akita11/EyeTracker/doc/README.md

* このファイルについて

EyeTrackのFPGAデザインに関する説明資料になります。
基板資料、FPGAデバイス資料についてはdoc以下のファイルを参照ください。

* FPGAデザイン

HUMANDATA社製　Xilinx社Kintex-7 FPGA搭載(Kintex-7 XC7K160T-1FBGA484) XCM-112基板向けデザインです、
関連資料については下記URLより参照ください。

http://www.hdl.co.jp/EDX-009/index.html
