akita11/EyeTracker/doc/EyeTracker -Register Specification-.pdf

Address | Mode | Data
UART_SW | R/W | 7 | 6 | 5 | 4 | 3 | 2 | 1 | 0
0x0000 | | - | - | - | - | - | - | - | SW
VGAOUT_MODE | R/W | 7 | 6 | 5 | 4 | 3 | 2 | 1 | 0
0x0001 | | - | - | - | - | - | - | - | VGAMD
THRESHOLD | R/W | 7 | 6 | 5 | 4 | 3 | 2 | 1 | 0
0x0002 | | THRESHOLD[7:0]
CURSOR_MODE | R/W | 7 | 6 | 5 | 4 | 3 | 2 | 1 | 0
0x0003 | | - | - | - | - | - | - | OUT_SEL | CURMD
SUM_S[ 7: 0] | R/O | 7 | 6 | 5 | 4 | 3 | 2 | 1 | 0
0x0004 | | SUM_S[ 7: 0]
SUM_S[15: 8] | R/O | 7 | 6 | 5 | 4 | 3 | 2 | 1 | 0
0x0005 | | SUM_S[15: 8]
SUM_S[15: 8] | R/O | 7 | 6 | 5 | 4 | 3 | 2 | 1 | 0
0x0006 | | - | - | - | - | SUM_S[23:16]
- | R/O | 7 | 6 | 5 | 4 | 3 | 2 | 1 | 0
0x0007 | | - | - | - | - | - | - | - | -
SUM_SX[ 7: 0] | R/O | 7 | 6 | 5 | 4 | 3 | 2 | 1 | 0
0x0008 | | SUM_SX[ 7: 0]

∑SX値

Reserved

∑S値

∑S値

∑S値

OUT_SEL : 0 = S/SX/SYを出力, 1 = S/QSX/QSYを出力(整数部12bit/小数部16bit)

SW : 0 = UARTを重心計算結果出力として使用 1 = UARTをHost IFとして使用

VGAMD : 0 = 2値化画像を出力 1 = Rawデータを出力

THRESHOLD[7:0] : 2値化のしきい値

CURMD : 0 = 重心カーソル表示Off, 1 = 重心カーソル表示On

SUM_SX[15: 8] | R/O | 7 | 6 | 5 | 4 | 3 | 2 | 1 | 0
0x0009 | | SUM_SX[15: 8]
SUM_SX[23:16] | R/O | 7 | 6 | 5 | 4 | 3 | 2 | 1 | 0
0x000A | | SUM_SX[23:16]
SUM_SX[27:24] | R/O | 7 | 6 | 5 | 4 | 3 | 2 | 1 | 0
0x000B | | - | - | - | - | SUM_SX[27:24]
SUM_SY[ 7: 0] | R/O | 7 | 6 | 5 | 4 | 3 | 2 | 1 | 0
0x000C | | SUM_SY[ 7: 0]
SUM_SY[15: 8] | R/O | 7 | 6 | 5 | 4 | 3 | 2 | 1 | 0
0x000D | | SUM_SY[15: 8]
SUM_SY[23:16] | R/O | 7 | 6 | 5 | 4 | 3 | 2 | 1 | 0
0x000E | | SUM_SY[23:16]
SUM_SY[27:24] | R/O | 7 | 6 | 5 | 4 | 3 | 2 | 1 | 0
0x000F | | - | - | - | - | SUM_SY[27:24]
Q_SX[ 7: 0] | R/O | 7 | 6 | 5 | 4 | 3 | 2 | 1 | 0
0x0010 | | Q_SX[ 7: 0]
Q_SX[15: 8] | R/O | 7 | 6 | 5 | 4 | 3 | 2 | 1 | 0
0x0011 | | Q_SX[15: 8]

∑SY値

Q_SX.F_SX = ∑SX/∑S

Q_SX.F_SX = ∑SX/∑S

∑SY値

∑SY値

∑SX値

∑SY値

∑SX値

∑SX値

Q_SX[23:16] | R/O | 7 | 6 | 5 | 4 | 3 | 2 | 1 | 0
0x0012 | | Q_SX[23:16]
Q_SX[27:24] | R/O | 7 | 6 | 5 | 4 | 3 | 2 | 1 | 0
0x0013 | | - | - | - | - | Q_SX[27:24]
Q_SY[ 7: 0] | R/O | 7 | 6 | 5 | 4 | 3 | 2 | 1 | 0
0x0014 | | Q_SY[ 7: 0]
Q_SY[15: 8] | R/O | 7 | 6 | 5 | 4 | 3 | 2 | 1 | 0
0x0015 | | Q_SY[15: 8]
Q_SY[23:16] | R/O | 7 | 6 | 5 | 4 | 3 | 2 | 1 | 0
0x0016 | | Q_SY[23:16]
Q_SY[27:24] | R/O | 7 | 6 | 5 | 4 | 3 | 2 | 1 | 0
0x0017 | | - | - | - | - | Q_SY[27:24]
F_SX[ 7: 0] | R/O | 7 | 6 | 5 | 4 | 3 | 2 | 1 | 0
0x0018 | | F_SX[ 7: 0]
F_SX[15: 8] | R/O | 7 | 6 | 5 | 4 | 3 | 2 | 1 | 0
0x0019 | | F_SX[15: 8]
F_SX[ 19:16] | R/O | 7 | 6 | 5 | 4 | 3 | 2 | 1 | 0
0x001A | | - | - | - | - | F_SX[19:16]

Q_SX = ∑SX/∑S

Q_SX.F_SX = ∑SX/∑S

Q_SX.F_SX = ∑SX/∑S

Q_SY.F_SY = ∑SY/∑S

Q_SY.F_SY = ∑SY/∑S

Q_SX.F_SX = ∑SX/∑S

Q_SY.F_SY = ∑SY/∑S

Q_SY.F_SY = ∑SY/∑S

Q_SX.F_SX = ∑SX/∑S

- | R/O | 7 | 6 | 5 | 4 | 3 | 2 | 1 | 0
0x001B | | - | - | - | - | - | - | - | -
F_SY[ 7: 0] | R/O | 7 | 6 | 5 | 4 | 3 | 2 | 1 | 0
0x001C | | F_SY[ 7: 0]
F_SY[15: 8] | R/O | 7 | 6 | 5 | 4 | 3 | 2 | 1 | 0
0x001D | | F_SY[15: 8]
F_SY[ 19:16] | R/O | 7 | 6 | 5 | 4 | 3 | 2 | 1 | 0
0x001E | | - | - | - | - | F_SY[19:16]
- | R/O | 7 | 6 | 5 | 4 | 3 | 2 | 1 | 0
0x001F | | - | - | - | - | - | - | - | -

Q_SY.F_SY = ∑SY/∑S

Reserved

Q_SY.F_SY = ∑SY/∑S

Q_SY.F_SY = ∑SY/∑S

Reserved
