akita11/EyeTracker/(threads)

Thread 1 (2017-04-01):

FRAME切り替え処理不具合

watari3, 2017-04-01:
Dual Port SRAMのm_MEMA0/m_MEMB0のアクセス制御に問題あり。
Multi Frame回路を実装して対応する必要あり。

A port側はカメラのフレームでアクセス切り替えするよう修正が必要か？？？
B port側は現行通りで問題なし。

watari3, 2017-05-23:
Close条件
・SIMでW/R処理が適切になされていることを確認すること(確認済み)
・実機でVGA出力(アナログRGB)に入力信号が出力されていること(下位３ビットは0)を確認すること(未確認)

watari3, 2017-06-05:
issue #20, issue #21にて個別に対応しているためissue #1は取り敢えずclose

Closed 2017-06-05.

Thread 2 (2017-04-01):

重心計算処理

watari3, 2017-04-01:
重心計算処理は参考資料通りに実装する。

計算途中のデータはF/Fで保持することとする。

watari3, 2017-04-15:
S/SX/SYの合計算出回路実装完了
除算は後ほど実装

akita11, 2017-05-29:
1つ確認をさせてください。実機での重心計算回路の検証は、どのように行われていますか？
カメラで適当な画像を撮り、その画像を動かすと、演算結果のS, SX, SYの値も、変化する（その値が正しいかは別として）、という動作は実機で確認していますか？

watari3, 2017-05-29:
かなり前のコードになりますが、vgaout_mode=0, threshold=0x01としてsum_s, sum_sx, sum_syが変わることをILAにて確認しております。
なお単体演算回路はシミュレーションで確認しております。

計算処理部分が少し特殊な記述で対応しているため合成時に変になる可能性は否定できません。
後ほど合成ログを確認してみます。

akita11, 2017-05-30:
CLctrl.vをみていて気づいたのですすが、二値化の処理、以下のようになっていますよね。
`oMEMIN_0[i  ] <= (iDATA_L>iTHRESHOLD) ? 1'b1: oMEMIN_0[i  ];`
これだと、輝度がiTHRESHOLDより大きい（明るい）画素が1になって、その画素にたいして重心計算されること、になりますよね。（この理解は正しいですか？）

本来行いたいのは、THRESHOLDよりも暗い画素に対する重心計算、なのですが、そのためには、この不等号は逆、という理解でよろしいですか？（この理解が正しいのであれば私のほうで修正しておきます）

watari3, 2017-05-30:
オリジナルのソースと思われるものが
oMEMIN_0[i ] <= (iDATA_L>iTHRESHOLD) ? 1'b1: oMEMIN_0[i ];
という記述でしたので、そのまま実装しています。

これが仕様とは正反対ということであれば修正が必要ですね。
こちらでも修正しておきます。

pushは私が行ったほうが良いでしょうか？

akita11, 2017-05-30:
私が今日の夕方にこの修正を行ってcommitしていますので、まずはそれをpullしてください。

またvgaout_mode=0(digitize)のときに、この二値化に基づいた画像がVGA側で表示されない原因は、なにか思い当たる節はありますか？

watari3, 2017-05-30:
issue #3 UART対応　の方に思い当たることを記載しました。
ご参照ください。

watari3, 2017-06-18:
除算含む重心計算処理を行い、VGA出力に重心位置を赤色で出力するよう実装。

watari3, 2017-06-26:
動作確認が取れた (issue #25 )ので本件close

Closed 2017-06-26.

Thread 3 (2017-04-01):

UART対応

watari3, 2017-04-01:
UART対応として以下の機能を実装する。
機能排他とするため、外部JPなどで切り替えを行う。

・内部レジスタアクセス制御(UART Tx, Rx使用)
・重心結果のみ出力

watari3, 2017-04-05:
UART回路としてUART_RX_CORE.v UART_TX_CORE.vを追加

上位層の回路作成必要

watari3, 2017-05-20:
上記「重心結果のみ出力」を実装済み。

akita11, 2017-05-21:
直接は関係ありませんが、TXとRXのピン番号指定が逆だったので、修正しておきました。

watari3, 2017-05-25:
改行コードを出力するように修正 (ステートマシーンの記述ミスを修正)

akita11, 2017-05-29:
UARTの出力で、ちょっと理解に苦しむところがあります。
カメラで撮っている画像や閾値の設定は適当ですので、出てくるS、SX、SYの値そのものは適当な値ということで、その妥当性は無視しています。

ロジアナ波形で、このような部分があります。
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

(1)この付近では、uart_dataに0x30があることから、これが送られているはずで、7bit/no parity/1stop
 bitだと、出力ビット列は、0 0000110 1、となるはずです。（最初の0がstart、最後の1がstop、その間の7bitが0x30）つまりこの青と黄のマーカの間隔は1bit分の時間ということになります。この青と黄のマーカの間隔は、この横軸では4519-4308=211ですが、オシロで計測すると9.2usとなっています。これは約115200bpsに相当しますが、ビットレートはその2倍の230400bps、のはずですよね。（つまりビットレートが115200bpsなのではないか？という推測）

(2)この付近で送っているデータ(uart_data)がこちら。
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
これをみると、19個の0x30のあと、0x00が送られています。
この0x00あたりを拡大したのがこちら。
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

0x30のあと、一瞬0xffになったあと、0x00になっています。
仕様では、区切りは0x0d、と記憶していますが、これはバグでしょうか。

akita11, 2017-05-29:
↑こちら、別便のメールで連絡をいただいていた、更新を反映させる前のものでした。失礼しました。これから反映させて試してみます。

akita11, 2017-05-29:
↑↑昨日の朝いただいた最新のリポジトリ(2017/5/28 20:14)をpullして書き込んでみました。
UARTから出てくるのは、230400bpsになりましたが、やはり19個の0x30＋0x00、の繰り返しです。
↑↑の(2)と(3)、確認＆情報ください。

watari3, 2017-05-29:
症状の確認をしたいと思います。
お手数ですが下記をご対応いただけないでしょうか。

1) JPのピン配置及び設定は適切か、
2) 改行コードが出力されていない、とは0x0Dが出力されていないとのことか。0x0A(LF)を出力する仕様ではなく0x0D(CR)を出力する仕様に変更すべきか。それとも0x0D, 0x0Aと出力すべきか。
3) TOP.vの後ろの記述を以下に変更しsum_sを観測しsum_sが0以外となっているか。
        .probe18(sum_s[7:0]/*VGA_R*/),
        .probe19(sum_s[8]/*clk_uart_x8*/),
        .probe20(sum_s[9]/*start_trig*/),
        .probe21(sum_s[10]/*uart_de*/),
        .probe22(sum_s[18:11]/*uart_data*/),
        .probe23(sum_s[19]/*tx_busy*/) /*,*/
4) vgaout_modeを0にした場合sum_sなどUARTの出力値が現在の結果から変化するか。

現在JP設定を疑っています。
またUARTの方は仕様の確認ということで質問しています。

ご対応いただければ幸いです。

watari3, 2017-05-29:
【仕様】
・sum_s(5キャラクタ)sum_sx(7キャラクタ)sum_sy(7キャラクタ)改行コード(1キャラクタ)
【バグ】
・改行コードが0x0と出力される。
・改行コードは0x0D
【対応方法】
・UART_IF.v/310行目 LSB側に詰めて設定しているものをMSB側に詰める様修正する必要あり
→next_hold_data  <= {8'h0A, 48'h0 };の様に修正

帰宅後にコードをコミットします。

akita11, 2017-05-30:
UART出力データの仕様→理解しました（確認ですが16進表記の5/7キャラクタ、ですよね？）。出てくるデータは上のほうに書いたのですが、改行コードと思われるところに0x00が出てきています。改行コードは、0x0aでも0x0dでも、その2つ、でもかまいません（PC側であわせます）。現行の仕様が0x0aのみ、なので、対応方法のところを読むと、0x0aの1バイトのまま、とするのがよさそうですね。↑の対応方法、というのを試してみたいと思います。

1.JPピン→上記の通り、適当に設定しています（本来はVGAOUT=0として二値化の状況を確認しながらJPを設定すべきですが、現在行っている動作チェックは、(a)生画像出力（これはOK）、(b)UARTから出てくる値のフォーマットの確認（19バイトの16進数文字＋改行コード、が出ているか。これは↑のとおり改行コードのところに0x00が出てきている）、です。S/SX/SYの値が、正しいかどうか、は、いまは気にしていません（正しい値を得るためにはJPを適切に設定する必要があるが、いまはそれ以前の段階）。
3.4.は、これからやってみます。

akita11, 2017-05-30:
↑の件、UART_IF.vに「対応方法」の修正を行い、改行コード0x0aが20バイトごとに出てくることは確認できました。
S/SX/SYの値はすべて'0'(0x30)となっていますが、これはJPの閾値の設定が不適切なのが原因と思われるので、引き続き調整してみます。

akita11, 2017-05-30:
JPの設定の件、原因がわかった気がします。状況確認とあわせて、読んでください。
まず確認ですが、vgaout_mode=0(digitized)のときは、JPで設定した閾値より明るい画素が"1"、それ以外の画素が"0"となって、VGA出力では、それに応じた二値画像が表示される、という動作という理解でよろしいですね？

で、ボードの回路図をみていただくとわかるのですが、JP[7:0]は、ショートピンをおくと3Vにつながるようになっています。つまりショートピンがない状態では0になるようにプルダウンされるべき信号です。
TOP_implement.tclでは、
`set_property PULLUP TRUE [get_ports [list JP[*]]]`
と書いてあるので、これを
`set_property PULLDOWN TRUE [get_ports [list JP[*]]]`
とすれば、プルダウンになって、ショートピンなし=0、あり=1、となるはずですよね。

で、このように書き換えてimplementをしてみたのですが、ショートピンがないピンが"1"のまま、で、プルダウンが効いていないっぽいです。
implementのレポート（以下）でピン配置結果をみると、PULLUPもPULLDOWMの指定されているっぽいところがないのですが、本来は、正しくPULLUP/DOWNが設定されると、このレポートのどこに出てくるか、わかりますか？（＝ここどこにもPULLUP/DOWNが出てこないのでTOP_implement.tclでのPULLUP/DOWNの指定の仕方が違うのではないか？と疑っている）
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

akita11, 2017-05-30:
↑の件、ImplementationのI/O planningでみると、JP[7:0]がPULLUP指定のままで、ここからPULLDOWNに指定できそうなので、やってみます。このTOP_implement.tclを明示的に読み込みなおす、とやらないと、反映されないんですかね。

akita11, 2017-05-30:
↑のPULLDOWN指定はうまくいきました（書き込んで、JPが、ショートピンなし＝"0"、あり＝"1"にできるようになった）。ただvgaout_mode=0(digitize)のときのVGAモニタに映る映像が、前面グレーのまま、です（中央やや下の左寄りに黒い四角が1個だけ現れる：以下の画像）。これはJPの設定をいろいろ変えてみましたが、映る映像は変わりません。
https://www.dropbox.com/s/yb3d01o3ajafzfo/2017-05-30%2012.58.50.jpg?dl=0

カメラに映している映像は、黒いところも明るいところもそれなりにある映像です（以下）。なおこの映像が、上のほうの細長い領域しか映っていないのは、仕様（カメラでそう設定している）で正しい現象です。
https://www.dropbox.com/s/p3v4wqy6yj755lb/2017-05-30%2012.58.05.jpg?dl=0

akita11, 2017-05-30:
（自分への備忘録）VGAout.vを読んで、vgaout_mode=0(digitize)のときのVGA出力が、画素ごとにフラグ=1→0xc0、フラグ=0→0x00、となるのは理解しました。ここですね。
```
    assign  mem_dat = (iVGAout_mode==1'b0) ? {sel_memout_0, sel_memout_0, 6'b000000}:
                                             {sel_memout_1, sel_memout_2, sel_memout_3, sel_memout_4, sel_memout_5, 3'b000};

```

akita11, 2017-05-30:
ILAの.proveで、JPの値を見たりしながら、いろいろいじってみました。わかったこと、おこった現象、をいくつか。
・ロジアナでJP（から設定されているthreshold）の値を読んだところ、ジャンパピンで設定したとおりの値になっていることは確認しました。つまり閾値の設定は正常。
・「重心計算処理」issueに書いたように、本来は重心の計算は黒画素に対して行うので、フラグを立てる条件式の不等号を逆（画素値＜threshold）にしました。vgaout_mode=0(digitize)時に表示される映像は、変化ありません。ただ、ときどき（再現性なし）、ここで、縦縞が出ることとがあります。カメラを動かすと、縦縞が変わったり消えたりします。（出ないときもある）。縦縞は、本当に縦縞で、X方向には何本かのグレー／黒の模様があり、Y方向にはその模様が一直線に続く、つまり画像メモリへのアクセスで、Y方向アドレスが一定になってしまっている、っぽい現象です。
・このときにUARTから出てくる値は、0ではない値のときがありました。ただこれも、画像を変えても変化しなかったり変化したり、と再現性がありません。

上記の変更をcommitしておきました。これらの現象の原因をみていただけますか。必要でしたら実機をお渡しします。

watari3, 2017-05-30:
Block RAMのWrite Depth/Read Depthの値が原因の可能性あり。

【MEM IPのアップデート手順】
・Project Manager WindowのSources WindowのIP sourceタグをクリック
・IP/MEMで右クリック→Re-customize IPを選択
・Port A Optionsタブを選択しWrite Depthを512から1024に変更
・OKをクリックしIPを再生成(Out of context per IP)

上記の手順でMEM.v(BRAM)を修正いただけないでしょうか。

こちらも同様の手順でデザインのアップデート、論理合成&配置配線を実行中です。

akita11, 2017-05-30:
こちら、いまやっています。

akita11, 2017-05-31:
↑の修正、やってみました。現象としては変化がありません。いくつか記録。
・生画像出力(vgaout_mode=1)では、特に問題なさそうに、カメラからの映像がモニタに表示される
・digitizeモード(vgaout_mode=0)では、最初縦縞。カメラに映る映像を変化させるとグレー一色（一箇所だけ黒点あり）。UARTから出てくるS/SX/SYの値は、この両者で別の値にはなっている（その値が正しいかは検証していない）。

akita11, 2017-05-31:
↑の件、その後いろいろ調べているのですが、理解に苦しんでいます。
CLctrl.vを見る限り、生画像も二値化後の画像も、同じようにメモリに書き込んでいて、
VGAoutのほうで、vgaout_modeに応じて、生画像または二値化画像を読みだしてDACへ出力していますよね。
ということは、生画像が問題なく表示されている（＝メモリへの読み書きとDAC出力はOK）ということは、二値化画像も、同じように問題なく表示されるはず、と理解しているのですが・・・

watari3, 2017-05-31:
私も上記の認識と同じです。

上記の件に関して、仕様確認したいことがあります。
以下についてお答えいただけないでしょうか。

【現状の仕様】
1) MEMOUTSELモジュールはVGACLKに同期して動作。その際のselect信号はVGAのタイミング回路で生成
2) カメラ側のビデオデータのSRAMへの書き込みはVGAのタイミング回路で生成されたfield(select)信号を元にVGAのタイミング回路がアクセスしていない方に対してWrite。

【確認事項】
a) 上記の1)と2)の仕様は正しいか。なおオリジナルソースに沿って上記を実装。
b) 実は1)は正しく2)はカメラ側のタイミングでWrite処理を切り替える必要があるのではないか。

watari3, 2017-05-31:
備忘録を兼ねて記載。

> ただ、ときどき（再現性なし）、ここで、縦縞が出ることとがあります。カメラを動かすと、縦縞が変わったり消えたりします。（出ないときもある）。縦縞は、本当に縦縞で、X方向には何本かのグレー／黒の模様があり、Y方向にはその模様が一直線に続く、つまり画像メモリへのアクセスで、Y方向アドレスが一定になってしまっている、っぽい現象です。

これはダブルバッファメモリへの書き込み制御信号を出力側のVGAのタイミング生成回路の信号を使用していることに起因していそうです。カメラ側で必要な信号(*1)を作りそれを元に動くよう変更すれば挙動が変わるような気がします。

*1)
カメラ側のフレームの切り替わりをトリガーに重心処理を行っているので、このタイミングでフレームの切り替わり信号（トグル信号）を生成する。

akita11, 2017-05-31:
上記(2)は、オリジナルがそんな実装になっていましたか・・・これは確かにおかしいですね。
あくまでも動作（field切り替えとメモリへの書き込みと重心計算）の基準はカメラ側のクロックで行われるべきで、VGA出力（メモリの読出し）は、どちらかのフィールド（固定でもいい）、でOKです。書き込みと読出しが非同期ですが、VGA出力はあくまでも目視確認用なので、VGA出力（読出し）中にカメラ側からの書き込みがはじまって、VGA出力映像が途中から、前のフィールドと次のフィールドが混在しても、まったく問題ありません。
つまり上記*1)とするように変更すべきです。

akita11, 2017-06-01:
あとUARTのピン配置。SC2_pin.xlsに載っているとおり、
信号名、FPGAピン、FTDI-Basicピン、の順に、
TX(FPGAの出力)、U17、2
RX(FPGAの入力)、W16、3
GND、-、5

watari3, 2017-06-13:
UARTによるHost I/Fを実装

issue #17 のcloseと同時に本件もcloseする予定

watari3, 2017-06-20:
issue #17 をcloseしたので本件もclose

Closed 2017-06-20.

Thread 6 (2017-05-20):

リポジトリの扱い方

akita11, 2017-05-20:
そちらの手元では、このリポジトリはどのように扱われていますか？
(1)実際にVivadoで作業しているディレクトリ自体が、リポジトリになっている
(2)他に作業しているフォルダがあって、適宜、その内容をリポジトリのディレクトリにコピーしてcommitをしている

(1)ならば、私の手元で加えた修正をcommitしたりしながら進めようとすると、
大量の中間ファイルをどう扱うべきか、という問題があります。
（.gitignoreで、これらのファイルを無視するのが現実的ではありますが・・・）

(2)ならば、そちらで修正を加えたものをこちらで試すだけなのであれば、
毎回clone(zipでDL)すればいいのですが、
・プロジェクトの設定ファイルが古いもので、いくつかの*.vがプロジェクトに含まれていなくて、手動で追加しないといけない
・ILAのIPコアが含まれていないので、これも以前いただいたプロジェクトファイル一式の中からコピーして追加しないといけない
という問題があります（手間がかかるだけ、といえばそうなのですが）。

まず(1)の(2)のどちらか、そして、上記の問題をどう解決するか、アドバイスをいただければ幸いです。

akita11, 2017-05-20:
とりあえず、最新のfeature/calculate_center_of_gravityブランチを手元にclone(zipでDL)して、手動で(2)のファイル・IPの追加を行って、論理合成などを行ってみます。
(2)ならば、少なくとも、必要なファイルの指定が含まれているプロジェクトファイルと、ILAの生成tclスクリプト、を、commitしていただけますか。

watari3, 2017-05-20:
現状は(1)になります。

大量の中間ファイルについてはディレクトリを保持つつignore設定するのが望ましいと考えています。

最終的には(2)のようなもの(tclにて全てを自動生成)を作る予定ですが、まず先に動くデザインを作ることを優先にしていますのでこのような形になっています。

このバージョンでファイルの追加は当面ないと考え(2)を取り組んだほうが良いですか。

akita11, 2017-05-20:
なるほど。では私の方で(1)をやってみたいと思います。いまのところ、私の方でいじったファイルはほとんどないので、私向けの一方通行がほとんどなので、あまり不具合はありません。ただ、プロジェクトファイルが古いままで一部の*.vが指定に入っていないのは面倒です。

（最新の）プロジェクトファイルと生成済みIPがリポジトリに含まれていないのは、何か理由がありますか？

直近のアクションとしては、明日に、いただいた最新のリポジトリのものでの実機の動作を試してみます。
あわせて、.gitignoreを書いてます。

watari3, 2017-05-20:
ILAはデバッグ用のIPであるということから敢えて登録していません。
プロジェクトファイルが古かったようですのでpushしておきました。

こちらのプロジェクトファイルにILAが含まれております。
ご面倒ですがpull後利用される際は、以前お渡しした一式からILAをコピーして利用ください。

デバッグ支援ということで、時間を見つけてILAを生成するtclを作成します。

akita11, 2017-05-20:
ありがとうございます、pullシタアト、ILAだけコピーして試してみます。

akita11, 2017-05-21:
pullしたあと、MEMとCLKGEN_MMCMをtclで生成し、ILAのIP(ILA.xcix)を、以前のプロジェクトからコピーして追加したあと、論理合成などをBitGenまで進めました。

ただ、以下のエラーが出ていました。CLKGEN_MMCMはtclで生成済みなので、無視してよいような気もしますが、一応報告します。
https://gyazo.com/ba72f3387e5cb22501e9b1243389c24e
これに関連して、こんなCritical Warningもでていました。
https://gyazo.com/b782a5e1d1805763b562ce26b6ae5660

あと、後学のために教えてください。生成済みIPをリポジトリにおかない理由はなんですか？ライセンスの関係？

あと、これも本筋ではないのですが、プロジェクトファイルで指定されているSIM_TOP_behav.wcfg（シミュレーション用の波形ファイル？）が、リポジトリに含まれていないようです。これも含まれない理由はなんですか？（特になければ、加えてもいいですか？）

あとVivadoでのもろもろの実行時に生成されるファイル群（ディレクトリ群）をリポジトリに含まないように、designs/FPGA/に .gitignore をおきました（これで問題はないはず）

watari3, 2017-05-21:
MEMの件ですがNGですね。後ほど対策します。
生成ずみIPを登録していない件ですが、こちらはツールのバージョンアップ対応のため敢えて登録していません。

シミュレーション用ファイル、特に波形定義ファイルはILA未登録の理由と同じくDebug用の為です。

akita11, 2017-05-21:
デバック用であっても、プロジェクトにふくまれるのであれば、
リポジトリに置いていただけませんか。
デバッグがすんだら、プロジェクトからはずせばよいので。

あとIPをリポジトリに含めない理由は理解しました。

2017年5月21日(日) 11:25 watari3 <notifications@github.com>:

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

watari3, 2017-05-21:
後ほどILAおよび波形定義ファイルを登録しておきます。

akita11, 2017-05-22:
5/23朝にmergeしてpushしていただいたリポジトリ(commit:d6aded0f896a7ca163b407c8cef3977a573a55cf [d6aded0])を、pullしてはしらせてみましたが、同じCLKGEN_MMCM関連のエラーが出るようです。
https://gyazo.com/c9416d04415e8a165a6c9b55301c3116

akita11, 2017-05-22:
あとあまり本題ではないと思いますが、シミュレーション用の波形ファイルが、まだないですね。

akita11, 2017-05-23:
あらためて、手元のディレクトリ一式を削除（リネーム）し、新たにcloneしてみましたが、CLKGEN_MMCMのIPを作成するtclを実行するところでエラーがでます。また各IPのファイル(*.xci)がない、というエラーもでます。以前のプロジェクトのファイル群と比べると、FPGA/project_1/project_1.srcs/sources_1/ip/ に、各IPのディレクトリ(CLKGEN_MMCM/等)がないのが原因のようです。（project1_src/以下を.gitignoreに追加してリポジトリに含めないようにしたのが原因なのかな・・・）

----------------
start_gui
open_project C:/work/EyeTracker/designs/FPGA/project_1/project_1.xpr
open_project C:/work/EyeTracker/designs/FPGA/project_1/project_1.xpr
CRITICAL WARNING: [Project 1-19] Could not find the file 'C:/work/EyeTracker/designs/FPGA/project_1/project_1.srcs/sources_1/ip/CLKGEN_MMCM.xcix'.
CRITICAL WARNING: [Project 1-19] Could not find the file 'C:/work/EyeTracker/designs/FPGA/project_1/project_1.srcs/sources_1/ip/CLKGEN_MMCM/CLKGEN_MMCM.xci'.
CRITICAL WARNING: [Project 1-19] Could not find the file 'C:/work/EyeTracker/designs/FPGA/project_1/project_1.srcs/sources_1/ip/MEM.xcix'.
CRITICAL WARNING: [Project 1-19] Could not find the file 'C:/work/EyeTracker/designs/FPGA/project_1/project_1.srcs/sources_1/ip/MEM/MEM.xci'.
CRITICAL WARNING: [Project 1-19] Could not find the file 'C:/work/EyeTracker/designs/FPGA/project_1/project_1.srcs/sources_1/ip/ILA.xcix'.
CRITICAL WARNING: [Project 1-19] Could not find the file 'C:/work/EyeTracker/designs/FPGA/project_1/project_1.srcs/sources_1/ip/ILA/ILA.xci'.
CRITICAL WARNING: [Project 1-19] Could not find the file 'C:/work/EyeTracker/designs/FPGA/project_1/project_1.srcs/sources_1/ip/CLKGEN_MMCM.xcix'.
CRITICAL WARNING: [Project 1-19] Could not find the file 'C:/work/EyeTracker/designs/FPGA/project_1/project_1.srcs/sources_1/ip/CLKGEN_MMCM/CLKGEN_MMCM.xci'.
CRITICAL WARNING: [Project 1-19] Could not find the file 'C:/work/EyeTracker/designs/FPGA/project_1/project_1.srcs/sources_1/ip/MEM.xcix'.
CRITICAL WARNING: [Project 1-19] Could not find the file 'C:/work/EyeTracker/designs/FPGA/project_1/project_1.srcs/sources_1/ip/MEM/MEM.xci'.
CRITICAL WARNING: [Project 1-19] Could not find the file 'C:/work/EyeTracker/designs/FPGA/project_1/project_1.srcs/sources_1/ip/ILA.xcix'.
CRITICAL WARNING: [Project 1-19] Could not find the file 'C:/work/EyeTracker/designs/FPGA/project_1/project_1.srcs/sources_1/ip/ILA/ILA.xci'.
Scanning sources...
Finished scanning sources
WARNING: [Project 1-509] GeneratedRun file for 'synth_1' not found
WARNING: [Project 1-509] GeneratedRun file for 'CLKGEN_MMCM_synth_1' not found
WARNING: [Project 1-509] GeneratedRun file for 'MEM_synth_1' not found
WARNING: [Project 1-509] GeneratedRun file for 'ILA_synth_1' not found
WARNING: [Project 1-509] GeneratedRun file for 'impl_1' not found
WARNING: [filemgmt 56-3] IPUserFilesDir: Could not find the directory 'C:/work/EyeTracker/designs/FPGA/project_1/project_1.ip_user_files'.
INFO: [IP_Flow 19-234] Refreshing IP repositories
INFO: [IP_Flow 19-1704] No user IP repositories specified
INFO: [IP_Flow 19-2313] Loaded Vivado IP repository 'C:/Xilinx/Vivado/2016.4/data/ip'.
open_project: Time (s): cpu = 00:00:08 ; elapsed = 00:00:08 . Memory (MB): peak = 849.594 ; gain = 157.586
source c:/work/EyeTracker/designs/src/tcl/generate_IP_design_CLKGEN_MMCM.tcl
# create_ip -name clk_wiz -vendor xilinx.com -library ip -version 5.3 -module_name CLKGEN_MMCM \
#           -dir c:/work/EyeTracker/designs/FPGA/project_1/project_1.srcs/sources_1/ip
INFO: [filemgmt 56-101] Creating core container 'c:/work/EyeTracker/designs/FPGA/project_1/project_1.srcs/sources_1/ip/CLKGEN_MMCM.xcix' for IP 'CLKGEN_MMCM'
WARNING: [filemgmt 56-12] File 'c:/work/EyeTracker/designs/FPGA/project_1/project_1.srcs/sources_1/ip/CLKGEN_MMCM.xcix' cannot be added to the project because it already exists in the project, skipping this file
# set_property -dict [list CONFIG.USE_MIN_POWER {true} CONFIG.RESET_TYPE {ACTIVE_LOW} CONFIG.RESET_PORT {resetn} \
#              CONFIG.PRIM_IN_FREQ {50} CONFIG.CLKOUT1_REQUESTED_OUT_FREQ {25} CONFIG.USE_SAFE_CLOCK_STARTUP {true} \
#              CONFIG.JITTER_SEL {No_Jitter} CONFIG.CLKIN1_JITTER_PS {200.0} CONFIG.CLKOUT1_DRIVES {BUFGCE} \
#              CONFIG.CLKOUT2_DRIVES {BUFGCE} CONFIG.CLKOUT3_DRIVES {BUFGCE} CONFIG.CLKOUT4_DRIVES {BUFGCE} \
#              CONFIG.CLKOUT5_DRIVES {BUFGCE} CONFIG.CLKOUT6_DRIVES {BUFGCE} CONFIG.CLKOUT7_DRIVES {BUFGCE} \
#              CONFIG.FEEDBACK_SOURCE {FDBK_AUTO} \
#              CONFIG.MMCM_DIVCLK_DIVIDE {2} CONFIG.MMCM_CLKFBOUT_MULT_F {24.125} CONFIG.MMCM_CLKIN1_PERIOD {20.0} \
#              CONFIG.MMCM_CLKOUT0_DIVIDE_F {24.125} CONFIG.MMCM_CLKOUT0_DUTY_CYCLE {0.5} \
#              CONFIG.CLKOUT1_JITTER {437.668} CONFIG.CLKOUT1_PHASE_ERROR {333.440}] [get_ips CLKGEN_MMCM]
# generate_target {instantiation_template} [get_files c:/work/EyeTracker/designs/FPGA/project_1/project_1.srcs/sources_1/ip/CLKGEN_MMCM/CLKGEN_MMCM.xci]
WARNING: [Vivado 12-1783] Unsupported target specified: 'instantiation_template'. Supported targets for this IP are: 'all'. File: 'CLKGEN_MMCM.xci'.
ERROR: [Vivado 12-1773] No legal targets specified.  Supported targets for this IP are: all. File: 'CLKGEN_MMCM.xci'.
WARNING: [Vivado 12-1783] Unsupported target specified: 'instantiation_template'. Supported targets for this IP are: 'all'. File: 'CLKGEN_MMCM.xci'.
ERROR: [Vivado 12-1773] No legal targets specified.  Supported targets for this IP are: all. File: 'CLKGEN_MMCM.xci'.
ERROR: [Common 17-39] 'generate_target' failed due to earlier errors.

    while executing
"generate_target {instantiation_template} [get_files c:/work/EyeTracker/designs/FPGA/project_1/project_1.srcs/sources_1/ip/CLKGEN_MMCM/CLKGEN_MMCM.xci]"
    (file "c:/work/EyeTracker/designs/src/tcl/generate_IP_design_CLKGEN_MMCM.tcl" line 26)
source c:/work/EyeTracker/designs/src/tcl/generate_IP_design_ILA.tcl
# create_ip -name ila -vendor xilinx.com -library ip -version 6.2 -module_name ILA \
#           -dir c:/work/EyeTracker/designs/FPGA/project_1/project_1.srcs/sources_1/ip
INFO: [filemgmt 56-101] Creating core container 'c:/work/EyeTracker/designs/FPGA/project_1/project_1.srcs/sources_1/ip/ILA.xcix' for IP 'ILA'
WARNING: [filemgmt 56-12] File 'c:/work/EyeTracker/designs/FPGA/project_1/project_1.srcs/sources_1/ip/ILA.xcix' cannot be added to the project because it already exists in the project, skipping this file
# set_property -dict [list \
#              CONFIG.C_PROBE23_WIDTH {1} CONFIG.C_PROBE22_WIDTH {8} CONFIG.C_PROBE21_WIDTH {1} CONFIG.C_PROBE20_WIDTH {1} \
#              CONFIG.C_PROBE19_WIDTH {1} CONFIG.C_PROBE18_WIDTH {8} CONFIG.C_PROBE17_WIDTH {1} CONFIG.C_PROBE16_WIDTH {1} \
#              CONFIG.C_PROBE15_WIDTH {4} CONFIG.C_PROBE14_WIDTH {1} CONFIG.C_PROBE13_WIDTH {1} CONFIG.C_PROBE12_WIDTH {1} \
#              CONFIG.C_PROBE11_WIDTH {1} CONFIG.C_PROBE10_WIDTH {1} CONFIG.C_PROBE9_WIDTH  {1} CONFIG.C_PROBE8_WIDTH  {1} \
#              CONFIG.C_PROBE7_WIDTH  {1} CONFIG.C_PROBE6_WIDTH  {1} CONFIG.C_PROBE5_WIDTH  {1} CONFIG.C_PROBE4_WIDTH  {8} \
#              CONFIG.C_PROBE3_WIDTH  {8} CONFIG.C_PROBE2_WIDTH  {1} CONFIG.C_PROBE1_WIDTH  {1} CONFIG.C_PROBE0_WIDTH  {1} \
#              CONFIG.C_DATA_DEPTH {65536} CONFIG.C_NUM_OF_PROBES {24}] [get_ips ILA]
# generate_target all [get_files c:/work/EyeTracker/designs/FPGA/project_1/project_1.srcs/sources_1/ip/ILA/ILA.xci]
# export_ip_user_files -of_objects [get_files c:/work/EyeTracker/designs/FPGA/project_1/project_1.srcs/sources_1/ip/ILA/ILA.xci] \
#                      -no_script -sync -force -quiet
# create_ip_run [get_files -of_objects [get_fileset sources_1] c:/work/EyeTracker/designs/FPGA/project_1/project_1.srcs/sources_1/ip/ILA/ILA.xci]
# export_simulation -of_objects [get_files c:/work/EyeTracker/designs/FPGA/project_1/project_1.srcs/sources_1/ip/ILA/ILA.xci] \
#                   -directory C:/work/EyeTracker/designs/FPGA/project_1/project_1.ip_user_files/sim_scripts \
#                   -ip_user_files_dir C:/work/EyeTracker/designs/FPGA/project_1/project_1.ip_user_files \
#                   -ipstatic_source_dir C:/work/EyeTracker/designs/FPGA/project_1/project_1.ip_user_files/ipstatic \
#                   -lib_map_path [list {modelsim=C:/work/EyeTracker/designs/FPGA/project_1/project_1.cache/compile_simlib/modelsim} \
#                   {questa=C:/work/EyeTracker/designs/FPGA/project_1/project_1.cache/compile_simlib/questa} \
#                   {riviera=C:/work/EyeTracker/designs/FPGA/project_1/project_1.cache/compile_simlib/riviera} \
#                   {activehdl=C:/work/EyeTracker/designs/FPGA/project_1/project_1.cache/compile_simlib/activehdl}] \
#                   -use_ip_compiled_libs -force -quiet
source c:/work/EyeTracker/designs/src/tcl/generate_IP_design_MEM.tcl
# create_ip -name blk_mem_gen -vendor xilinx.com -library ip -version 8.3 -module_name MEM \
#           -dir c:/work/EyeTracker/designs/FPGA/project_1/project_1.srcs/sources_1/ip
INFO: [filemgmt 56-101] Creating core container 'c:/work/EyeTracker/designs/FPGA/project_1/project_1.srcs/sources_1/ip/MEM.xcix' for IP 'MEM'
INFO: [Device 21-403] Loading part xc7k160tfbg484-1
WARNING: [filemgmt 56-12] File 'c:/work/EyeTracker/designs/FPGA/project_1/project_1.srcs/sources_1/ip/MEM.xcix' cannot be added to the project because it already exists in the project, skipping this file
# set_property -dict [list CONFIG.Memory_Type {True_Dual_Port_RAM} \
#              CONFIG.Algorithm {Low_Power} \
#              CONFIG.Write_Width_A {640} CONFIG.Write_Depth_A {512} CONFIG.Read_Width_A {640} CONFIG.Operating_Mode_A {NO_CHANGE} \
#              CONFIG.Write_Width_B {640} CONFIG.Read_Width_B {640} CONFIG.Operating_Mode_B {NO_CHANGE} CONFIG.Enable_B {Use_ENB_Pin} \
#              CONFIG.Register_PortA_Output_of_Memory_Primitives {true} CONFIG.Register_PortB_Output_of_Memory_Primitives {true} \
#              CONFIG.Port_B_Clock {100} CONFIG.Port_B_Write_Rate {50} CONFIG.Port_B_Enable_Rate {100}] [get_ips MEM]
# generate_target all [get_files  c:/work/EyeTracker/designs/FPGA/project_1/project_1.srcs/sources_1/ip/MEM/MEM.xci]
# export_ip_user_files -of_objects [get_files c:/work/EyeTracker/designs/FPGA/project_1/project_1.srcs/sources_1/ip/MEM/MEM.xci] \
#                      -no_script -sync -force -quiet
# create_ip_run [get_files -of_objects [get_fileset sources_1] c:/work/EyeTracker/designs/FPGA/project_1/project_1.srcs/sources_1/ip/MEM/MEM.xci]
# export_simulation -of_objects [get_files c:/work/EyeTracker/designs/FPGA/project_1/project_1.srcs/sources_1/ip/MEM/MEM.xci] \
#                   -directory C:/work/EyeTracker/designs/FPGA/project_1/project_1.ip_user_files/sim_scripts \
#                   -ip_user_files_dir C:/work/EyeTracker/designs/FPGA/project_1/project_1.ip_user_files \
#                   -ipstatic_source_dir C:/work/EyeTracker/designs/FPGA/project_1/project_1.ip_user_files/ipstatic \
#                   -lib_map_path [list {modelsim=C:/work/EyeTracker/designs/FPGA/project_1/project_1.cache/compile_simlib/modelsim} {questa=C:/work/EyeTracker/designs/FPGA/project_1/project_1.cache/compile_simlib/questa} {riviera=C:/work/EyeTracker/designs/FPGA/project_1/project_1.cache/compile_simlib/riviera} {activehdl=C:/work/EyeTracker/designs/FPGA/project_1/project_1.cache/compile_simlib/activehdl}] \
#                   -use_ip_compiled_libs -force -quiet

Thread 8 (2017-05-20):

コンソール上で作業できるtclファイルの提供

watari3, 2017-05-20:
CUIにてプロジェクトデザインの生成を行うtclファイルを提供する。

watari3, 2017-05-28:
暫定版をpush。
但しRTL及びIPの追加でfail。

watari3, 2017-05-30:
備忘録を兼ねています。

tclでのILA生成について調査する必要あり。
暗号化された3つのVerilog Core Fileを読み込む必要があるかどうか調査すること。

akita11, 2017-05-30:
これも優先度低めでいいですよね。回路のデバッグを優先で。

watari3, 2017-06-20:
参考資料のURL

https://www.xilinx.com/support/documentation/sw_manuals/xilinx2017_1/ug939-vivado-designing-with-ip-tutorial.pdf

https://www.xilinx.com/support/documentation/sw_manuals/xilinx2017_1/ug896-vivado-ip.pdf

watari3, 2017-06-24:
プロジェクトタイプと非プロジェクトタイプの２種類を提供する予定

リリース順は以下の通り

- 非プロジェクトタイプ
- プロジェクトタイプ

watari3, 2017-06-25:
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

push済み

> - プロジェクトタイプ

調査開始

Thread 10 (2017-05-21):

HSYNC/VSYNCの極性？

akita11, 2017-05-21:
.iVSYNC_POL(1'b1), .iHSYNC_POL(1'b1),というのが追加されているようですが、HSYNC/VSYNCの極性を指定できるようにしていただきましたか？（確認）

watari3, 2017-05-22:
出力側のタイミング及び制御信号はTMG_CTRL.vにて正論理で生成されています。
最終段出力に当たるOUT_VIDEO_DATA.vのiVSYNC_POL, iHSYNC_POLにて極性を反転できるようになっています。
0は極性反転なし、1は極性反転あり、となります。

Closed 2017-05-22.

Thread 11 (2017-05-22):

CLKGEN_MMCM関連のエラー

watari3, 2017-05-22:
generate_IP_design_CLKGEN_MMCM.tclに不具合あり。
修正が必要。

akita11, 2017-05-23:
いつごろ修正fixできそうですか？

watari3, 2017-05-23:
３箇所の"#"を削除。
これで問題が改善するか確認願います。

watari3, 2017-05-23:
こちらの環境では正しく動作出来ていそうです。

発生原因として推測されている「FPGA/project_1/project_1.srcs/source_1/ip/に各IPディレクトリがない」についてこちらでも調査いたします。

なおこちらの認識ではgenerate_IP_design_CLKGEN_MMCM.tclの26～27行目にて必要なファイルが生成及びプロジェクトへ登録されると思っています。

akita11, 2017-05-24:
新たにpullしたものに対して、tclで生成すると、そのファイルはすでにプロジェクトに含まれる、というエラーがでます。
以下、順に。

まず新たにpullし、プロジェクトを開くと以下のメッセージが出ます。
https://gyazo.com/1e64ba4aa27a1dc875a001818c405b9b
CLKGEN_MMCMがない、というのがcritical warningですね。

この状態で、プロジェクトのファイル構成は、こんな感じです。
https://gyazo.com/df7e7e2cf7004ffaeb85bd6d08659965
3つのIPが、？になっています。

その後、generate_IP_design_CLKGEN_MMCM.tclをsourceした結果がこちらです。
https://gyazo.com/042aa9aaa113823d04b9588c1e4caf3e
既にプロジェクトに含まれるのでskipされています。

本来は、この段階で3つのIPをtclスクリプトで生成すれば、*.xciが作成され、
プロジェクトのファイル構成にある？が解消されるはず、なのですが、
これはどういうことでしょうか。

akita11, 2017-05-26:
最新版（今朝の時点で）を新たにpullしてプロジェクトを開いたあとでtclで生成すると、やはり同様のエラーが出ます。
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

watari3, 2017-05-30:
備忘録を兼ねて記載します。

抜本的な対策が必要と思われる。
Linux環境下で何種類化のテストコードを用意しテストすること。

tclベースの合成＆配置配線スクリプトを実行するとCLK周りでFailする。
CLK信号の扱いについて考察する必要あり。

akita11, 2017-05-30:
これは優先度低めでいいですよね。回路のデバッグを優先で。

watari3, 2017-06-28:
本件
C:\work\EyeTracker\designs\FPGA\project_1\project_1.ip_user_files\ip
ディレクトリ内にCLKGEN_MMCMディレクトリがなく
C:\work\EyeTracker\designs\FPGA\project_1\project_1.srcs\sources_1\ip\CLKGEN_MMCM.xcix
ファイルが存在している場合に発生する。

C:\work\EyeTracker\designs\FPGA\project_1\project_1.srcs\sources_1\ip\CLKGEN_MMCM.xcixを削除後、vivado上からIP SourcesのCLKGEN_MMCMを削除し再度該当tclファイルを実行することで問題解決。

上記対応で問題が解決することを確認済み。
以上より本件closeします。

Closed 2017-06-28.

Thread 13 (2017-05-24):

制御系仕様整理

watari3, 2017-05-24:
- CAMERA_LINK
FVAL, LVAL, DVAL : 正論理
内部制御回路用にFVAL, LVALから論理反転などを行い正論理のVSYNC, HSYNCを生成する必要あり

- VGA_OUT (アナログビデオ)
VSYNC, HSYNC : VGA(640x480@60Hz)出力であるためVESAの規格よりVSYNC, HSYNCは負論理
しかし基板上のでインバーターにてDAC用の信号を生成している(3.3V->5V変換)ため正論理で出力する必要あり

- ビデオ系制御信号
VSYNC, HSYNC, DE : 正論理
内部回路は正論理前提

watari3, 2017-05-25:
内部制御信号の極性不一致により不具合発生。

修正することで正常に動作することを確認済み。

Closed 2017-05-25.

Thread 14 (2017-05-25):

Rowデータのbit精度

watari3, 2017-05-25:
内蔵SRAMのビット制約(オリジナルデザインSpartan6縛り)により現状カメラ入力の上位5bitを保持しています。

Kintex-7 160Tに変更になったので多少(1bit程度?)は追加できると思われますが、やってみないとわからない&ILAの完全削除が必須です。

下記のどれを選択し実装すればよいでしょうか。
ご意見をいただけないでしょうか。

a) 現行デザインのまま上位5bitのみを保持 (ILAはそのまま)
b) 上位3bitを捨てて下位5bitのみを保持 (ILAはそのまま)
c) 上位3bitを捨てて下位5bitを3bitシフト(８倍)して保持 (ILAはそのまま)
d) ILAを完全削除し上位6bitを保持 (ILAを削除。失敗の可能性あり)
e) その他

akita11, 2017-05-25:
現行のまま上位5bit保持の(a)でお願いします

>

Thread 15 (2017-05-29):

VGA DAC出力の件

akita11, 2017-05-29:
カメラの画像に応じて、VGA_R_OBUFは、それらしく変化しているっぽい（真っ暗だと常に0x00、光を入れると0xc0などの値がDVALにあわせて現れる）。DACの出力電圧も、それに応じて変わっている(1Vpp程度)。
ただしモニタとVGAケーブルでつなぐと、出力振幅が150mVpp程度まで下がってしまい、モニタに映る絵はグレーのまま。DAC出力駆動回路を要調査。

akita11, 2017-05-29:
モニタを変えたら、生画像が問題なく出力されました・・・

akita11, 2017-05-29:
というわけで生画像出力の問題は解決しました。

Closed 2017-05-29.

Thread 16 (2017-05-30):

重心処理に使用するしきい値の仕様

watari3, 2017-05-30:
仕様の確認及びRTLの修正が必要

【仕様】
誤) カメラからの入力データがしきい値を超えたら1とする
正) カメラからの入力データがしきい値を下回ったら1とする

【修正】
修正前)
CLctrl.vの115, 116行目
                    oMEMIN_0[i  ] <= (iDATA_L>iTHRESHOLD) ? 1'b1: oMEMIN_0[i  ];
                    oMEMIN_0[i+1] <= (iDATA_R>iTHRESHOLD) ? 1'b1: oMEMIN_0[i+1];
修正後)
CLctrl.vの115, 116行目
                    oMEMIN_0[i  ] <= (iDATA_L<iTHRESHOLD) ? 1'b1: oMEMIN_0[i  ];
                    oMEMIN_0[i+1] <= (iDATA_R<iTHRESHOLD) ? 1'b1: oMEMIN_0[i+1];

akita11, 2017-05-30:
この「正」のほうが正しい仕様です。

watari3, 2017-05-30:
仕様の間違いを認識＆修正されていることを確認しましたので本件closeします。

Closed 2017-05-30.

Thread 17 (2017-05-31):

UARTによる内部レジスタアクセス

watari3, 2017-05-31:
デバッグ・設定値変更のためにUARTによる内部レジスタアクセス機能を検討する。

とりあえずは仕様検討のみ。

【仕様案】
- Plan 1
・内部レジスタへの書き込み
Input : "wr 4桁のアドレス(2バイト/16進アスキーキャラ) 4桁のデータ(2バイト/16進アスキーキャラ)"+"lf"
Output : コマンドが認識されたら"OK"+"lf"、認識されなかったら"NG"+"lf"を出力
・内部レジスタの読み込み
Input : "rd 4桁のアドレス(2バイト/16進アスキーキャラ)"+"lf"
Output : コマンドが認識されたら"リードした4桁のデータ(2バイト/16進アスキーキャラ)"+"lf"+"OK"+"lf"、認識されなかったら"NG"+"lf"を出力

- Plan 2
Microblaze(ソフトCPU)にてUART処理を実装する。

watari3, 2017-06-08:
feature/support_host_if ブランチにてHost IFを実装していく。

watari3, 2017-06-11:
下記仕様で(別プロジェクトで)実装、Sim完了。

【仕様】
- 内部レジスタへの書き込み
Input: "wr 4桁のアドレス(2バイト/16進アスキーキャラクタ) 2桁のデータ(1バイト/16進アスキーキャラクタ)"+"lf"
Output: コマンドが認識されたら"OK"+"lf"、認識されなかったら"NG"+"lf"を出力
- 内部レジスタへの書き込み
Input: "rd 4桁のアドレス(2バイト/16進アスキーキャラクタ)"+"lf"
Output: コマンドが認識されたら"OK"+"lf"+"リードした2桁のデータ(1バイト/16進アスキーキャラクタ)"、認識されなかったら"NG"+"lf"を出力

BSをサポート。

watari3, 2017-06-11:
上記機能の移植について質問です。

下記のどちらがよろしいでしょうか。

1) UARTは1つ。"start"+"lf"と"stop"+"lf"で重心計算の結果出力とHost I/Fを切り替える
2) UARTは2つ。

akita11, 2017-06-11:
2.だとHW（ボード）に変更が必要なので、
1.を希望します。

watari3, 2017-06-11:
分かりました。
1で移植を行います。

watari3, 2017-06-13:
feature/support_host_if ブランチにてUARTによるHost I/Fを実装しました。
後ほどレジスタ表と使い方を記載いたします。

watari3, 2017-06-13:
レジスタ表を下記として登録

doc/EyeTracker -Register Specification-.pdf

【使い方】
"stop"+"lf"→UART I/Fを重心計算出力モードからUART Host I/Fモードに切替
"start"+"lf"→UART I/FをUART Host I/Fモードから重心計算出力モードに切替
それ以外は前出の仕様参照のこと

レジスタの意味などについてはレジスタ表を参照のこと

akita11, 2017-06-14:
pullして論理合成して動作させてみました。startとstopは動作OKです。
wrとrdの挙動がちょっと謎なところがあるので報告します。

以下、いくつかレジスタのアクセスをした結果（//以下は私が入れたコメント）ですが、書き込みがうまくいくときといかないときがあります。
まず確認ですが、wrコマンドの書式は、
(a)"wr"+<SPC>+<アドレス4桁>+<データ2桁>
(b)"wr"+<SPC>+<アドレス4桁>+<SPC>+<データ2桁>
のどちらでしょうか。
以下のログでは、(2)のところを見る限り、(a)のように理解できるのですが、同じ文字列を別のときに書き込んだときは、正しいあたいが書き込まれない(0x10を書き込んだあとでrdすると0x00のまま、など)ときがあります。（再現性がありそうでなくて、パターンをまだつめきれていない）

またこれも確認ですが、rd/wrコマンドは、start後で重心がUART出力されるときでも受け付けますか？それとも、いったんstopした後でないと受け付けない？

あともう1つ、wrコマンドでVGAOUTMODE(0x0001)を書き換えると、すぐにVGA出力がraw/digitizedで切り替わりますか？

```
wr 0002 10 // write THRESHOLD=0x10 (1)
OK

rd 0002    // read THRESHOLD=0x01?
OK
01

wr 000210  // write THRESHOLD=0x10 (2)
OK

rd 0002    // read THRESHOLD=0x10
OK
10

wr 000101  // write VGAOUTMODE=1(raw)
OK

rd 0001    // read VGAOUTMODE=0? (3)
OK
00

wr 000100  // write VGAOUTMODE=0(digitized)
OK

rd 0001    // read VGAOUTMODE=0(digitized)
OK
00

```

watari3, 2017-06-14:
> pullして論理合成して動作させてみました。startとstopは動作OKです。
> wrとrdの挙動がちょっと謎なところがあるので報告します。
> 以下、いくつかレジスタのアクセスをした結果（//以下は私が入れたコメント）ですが、書き込みが> うまくいくときといかないときがあります。

クロック載せ替え処理に問題がありそうと思われます。
只今デバッグ中ですのでしばらくお待ち下さい。

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

厳格に入力コマンドチェックをしていませんでしたので不思議な挙動になっておりました。
次のpush(おそらく6/15朝)で仕様どおりに動作するよう変更します。
なおコマンドについてはdesigns/sim/testbench/SIM_TOP.vの173行以降を参考ください。

>またこれも確認ですが、rd/wrコマンドは、start後で重心がUART出力されるときでも受け付けますか？それとも、いったんstopした後でないと受け付けない？

Host側が"OK" or "NG"を受信するまでをコマンドの仕様(除くstart)としているため、
基本仕様として不可ですが、内部動作としてwrコマンドは実行されます。

>あともう1つ、wrコマンドでVGAOUTMODE(0x0001)を書き換えると、すぐにVGA出力がraw/digitizedで切り替わりますか？

即時反映としているためすぐに切り替わります。
レジスタ値の反映をV Syncが来てからに変更したほうが良いですか？

akita11, 2017-06-14:
動作仕様、理解しました。仕様自体はこれでOKです。
念のため確認ですが、PCからの送信も、7bit/parityなし/stop1bit、ですよね？

watari3, 2017-06-14:
はい。そのとおりです。

UARTの仕様はTOP.vのUART_TX_CORE及びUART_RX_COREをインスタンシエーションしている部分を見ていただければお分かりいただけます。
なおこちらを修正することで変更も可能です。

akita11, 2017-06-15:
いただいたものをpullしてブランチfeature/support_hostifに切り替えて試してみました。（割り算器の生成はtclでOKでした）
ただwrコマンドが、すべてNGとなるようです。
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

watari3, 2017-06-18:
修正しました。

watari3, 2017-06-20:
一通りアクセスできるようになったので本件closeします。

Closed 2017-06-20.

Thread 19 (2017-06-01):

静止画像に対してS/SX/SYがほぼ一定となること

akita11, 2017-06-01:
カメラを固定し、静止物体を撮影した状態で、S/SX/SYの値がほぼ一定（多少±10程度のバラツキは許容）となること。S/SX/SYの演算結果が正しいことの簡便な判定方法・

watari3, 2017-06-01:
関係あるかわからないが6/1 PM4:00のコードではHSIZEの検出方式に問題あり。修正版をPush済み。(実機未確認)

watari3, 2017-06-02:
カメラからの入力信号, DVAL, FVALから入力解像度を判定する際の仕様確認

【仕様確認】
現在pushされているデザインは以下のタイミングでHSIZE(水平方向の解像度)、VSIZE(垂直方向の解像度)が更新される。

・DVALの立ち下がりタイミングでHSIZEを更新
・FVALの立ち上がりタイミングでVSIZEを更新

上記仕様ではチャタリングが発生したとき(信号が不安定なとき)、挙動が不安定になる。

a) 不安定であっても一瞬のことなので問題なし
b) 値が安定してから値の更新を行う

上記のどちらの仕様が望ましいか。

akita11, 2017-06-02:
チャタリング、というのは、具体的にはどれぐらいバラつくのでしょうか。例えば300のところが100くらいとか大きく変わったりしますか？
いずれにしても各フレームで更新しますから、次のフレームでは戻っていますよね。であればa)がいいです。

watari3, 2017-06-02:
デバッグをしてみました。
画面にノイズがのっているので安定していませんが以下のような結果が出力されています。
先日の静止画とはどんな条件で表示されていたのでしょうか。

0B468032BA352568FAC
0984003371A0118B45C
09AF80345CCC125126A
0AB93035649920BFAB5
09AF80345CCC125126A
0AB93035649920BFAB5
09AF80345CCC125126A
0AB93035649920BFAB5
09AF80345CCC125126A
0AB93035649920BFAB5
0C30B036EDC726690E9
09D020350D2D1264C10
0C312036EDC726690E9
09D020350D2D1264C10
0C312036EDC726690E9

akita11, 2017-06-02:
↑でSをみると、1行目と2行目で0xb468=46184、0x9840=38976ですので、値に15%ぐらいの差があります。客観的に見てカメラも対象物も静止していて、照明も一定であれば、これほどの差は出ないはずです。
「先日の静止画」というのが何を指しているのかわからないのですが、↑のほうに目安として書いたバラツキ±10というのは、以前バージョンのものが正常に動いて眼球を観測していたときに出力されていたSの値のバラツキはこれくらいだったよなあ、という記憶のものです。ですので、これぐらいの精度は出るはずなので、正常動作の判断の目安としてあげました。

watari3, 2017-06-02:
過去の性能(ばらつき)について理解しました。

現在値が安定しないのは画面にノイズがのっている事に起因していますのでノイズの要因を調査します。

以下ノイズの要因として考えられるものです。
何か気づく点がありましたらアドバイスいただけないでしょうか。

1) そもそもカメラから入力されるFVAL, DVAL, VVALに想定外の信号が存在している
2) (可能性はかなり低いが)Dual Port SRAMでアクセスの衝突が多発している
3) メモリアクセスに使用しているアドレスの値がおかしい

画面を見ていると1)の可能性が高いと思われます。

watari3, 2017-06-02:
ティアリングの影響or私の家の照明の影響で画面にホワイトノイズが発生する以外問題ないことを確認済み

akita11, 2017-06-04:
実験環境をきちんと設定して実験を行ってみました。
結論として、
(1) 静止物体に対してS/SX/SYはほぼ一定となる（動作OK）
(2) 対象物の位置を移動すると、それに応じて、Sは一定のまま、SXとSYは変化する（ほぼ動作OK：後述）
(3) S/SX/SYから求めた重心の値は、画面上の重心の位置と一致していそう（ほぼ動作OK：後述）
(4) ただ、S/SX/SYから求めた重心座標のx,yが逆っぽい。対象物を水平に移動するとSXが一定でSYが変化する。→SXとSYが出てくる順序が逆で、S/SY/SXの順でUART出力されていないか？（推測）
(5) UARTから出てくる値が、すべて0という行が、ほぼ半分ある。上記(1)-(4)は、UARTから出てくる値のうち、このすべて0という行以外のものに対して。
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
オシロ実測でもロジアナ実測でも、そういう行はある。（'0'=0x30で、この部分ではUART_TXDに0x30が続いている。
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
なおUART波形を見る限り、データのかたまり(正しいS/SX/SYの値の行 or すべて0の行をあわせて)の周期はカメラのフレームレートの周期と一致している。

(4)はそれほど大きな問題ではない（最悪、受信側でSXとSYを逆にすればよい）のですが、(5)はちょっと問題です。つまりフレームごとの重心計算が50%ほどできていない、っぽい。別issueのSRAM書き込みの話と関連しますが、何か考えられる対策はありますか？

watari3, 2017-06-05:
上記(5)については issue #20 の修正を行うことで解決するはず。
上記(4)については以下の修正を行うことで解決。

- TOP.v/330行目の.iSUM_SX(sum_sy)を.iSUM_SX(sum_sx)に変更
- TOP.v/331行目の.iSUM_SY(sum_sx)を.iSUM_SY(sum_sy)に変更

watari3, 2017-06-08:
修正完了したのでclose.

Closed 2017-06-08.

Thread 20 (2017-06-01):

raw/digitized画像のVGA表示のチラツキ

akita11, 2017-06-01:
カメラとVGAが非同期ではあるものの、ちょっとチラツキが大きいような気もする。これが正しい動作なのかは要検証。

watari3, 2017-06-02:
WE信号の生成に起因する問題の様に思われる。
オリジナルソースを元に実装したことが原因の可能性あり。

次の合成＆配置配線をするタイミングで修正デザインを用意して確認する予定。

watari3, 2017-06-02:
重心計算中にWEがONとなるタイミングがありデータを破壊。
重心計算中はWEを0に、またDEに同期してWEの処理行うように修正することで画面が安定することを確認済み。

watari3, 2017-06-05:
フレームバッファの切り替え処理に問題があり重心計算がおかしくなる。

修正箇所は以下の２点

- INP_CAMERA_DATA.v/95行目のrise_vsyncをfall_vsyncに変更
- TOP.v/166行目の.iMEM_SEL(mem_sel_sync_cclk)を.iMEM_SEL(cmr_field)に変更

watari3, 2017-06-08:
修正完了したのでclose

Closed 2017-06-08.

Thread 21 (2017-06-03):

SRAM読出しタイミング・競合

akita11, 2017-06-03:
状況の整理を兼ねて。
・SRAMへの書き込みはカメラのクロックに同期して、カメラから
・SRAMからの読出しは、(a)VGA出力読出し(25MHz)と、(b)重心計算読出し(カメラクロック同期)の2系統
・SRAMは2バンクあり、カメラのフレームにあわせて、書き込みと(b)読出しを別バンクで交互に行う
・SRAMへのアクセスで書き込みと読出しが競合（ハザード）しうるのは、書き込みと(a)読出しだけ、のはず。ただしこの読出し時のハザードは、VGA出力のチラツキ現象として観測されるはず。この現象は重心計算には無関係のはず。
・（要確認事項）(a)読出しをどちらのバンクから行うかは、どう決めているか？→現実的には、カメラで書き込みを行っているバンク（＝(b)読出しとは別のバンク）に対して行うべき、のはず。（(a)読出しと(b)読出しは同時に行えないので）
※理想的には3ポートRAM（書き込みx1と読出しx2）があるとこれらは完全に解決できますが・・・

watari3, 2017-06-04:
状況の整理に関して個人的見解を記載します。詳細に関しては下記備忘録の資料を読む必要があります。
（時間がなかったため先にこの文書を記載）

4) はSRAMの仕様か設定でどのような状況になるか決定するはず。（下記資料を読み解く必要あり）
5) に関しては重心計算はSP, フレームバッファはTDPを使用することで回避出来ますがBRAMの数次第

備忘録
下記資料のCollisionに関する資料を読む
https://japan.xilinx.com/support/documentation/user_guides/j_ug473_7Series_Memory_Resources.pdf

watari3, 2017-06-04:
SRAMが不足する場合はフレームバッファとしてDRAMを使用するか。

watari3, 2017-06-04:
競合問題を回避する方法

下記のどちらかで問題解決するのではないか。

1) SRAMのIPの設定を変更する(Port A Options & Port B OptionsのOperating ModeをNO_CHANGEからWrite Firstに変更)
2) 重心処理計算をSinglePort SRAM, Frame BufferをTrue Dual Port SRAMで実装

akita11, 2017-06-04:
まず現状を確認させてください。↑に書いたうち以下の2点です。
(1)SRAMへのアクセスで書き込みと読出しが競合（ハザード）しうるのは、書き込みと(a)読出しだけ、のはず。ただしこの読出し時のハザードは、VGA出力のチラツキ現象として観測されるはず。この現象は重心計算には無関係のはず。
→この理解は正しいですか？

(2)（要確認事項）(a)読出しをどちらのバンクから行うかは、どう決めているか？→現実的には、カメラで書き込みを行っているバンク（＝(b)読出しとは別のバンク）に対して行うべき、のはず。（(a)読出しと(b)読出しは同時に行えないので
→現状は、(a)読み出し（VGA読み出し）をどちらのバンクから行っていますか？

akita11, 2017-06-04:
生画像／二値画像をDRAMに格納するようにするとすると、どれぐらいの工数（改造）になりますか？
それとも、重心計算もあわせて、DRAMに入れることを考えていますか？その場合は、どれぐらいの工数になりますか？

watari3, 2017-06-04:
(1)ですが、私が書いた設定を変更しない場合、その理解にならない場合があります。
(2)ですが、重心処理は書き込みが完了したバンクを読んでいるつもりですが、帰ってきてから確認します。違う場合はFVALの立ち下がりでバンク切り替えをするように変更します。

DRAMの場合はそこそこ時間がかかるはずなのでSingle Port SRAMを1つ追加のほうが工数が少ないと思っています。

akita11, 2017-06-04:
(1)で「その理解にならない」とは、具体的にはどのような現象をさしていますか？
(A)SRAMへのアクセスで書き込みと読出しが競合（ハザード）しうるのは、書き込みと(a)読出しだけ、のはず
(B)ただしこの読出し時のハザードは、VGA出力のチラツキ現象として観測されるはず。この現象は重心計算には無関係のはず。
の、どちらですか？

akita11, 2017-06-04:
↑↑でDRAMを使う場合は工数が多そう、ということは理解しました。SinglePortSRAMを追加するリソースはありましたっけ？あ、でも、現行で、重心計算＆VGA出力用があわせてdepth=6bitなのを
・二値化フラグ格納＆重心計算用のSP(depth=1bit)
・生画像or二値化フラグ格納＆VGA出力用のTDP(depth=現行5bitだがこれより少なくてもOK)
に分けるだけなので、BlockRAMリソースとしては、それほど変わらない（＝大きな変更はないので工数が少ない）、という理解であってますか？

watari3, 2017-06-05:
少し異なりますので補足いたします。

> (A)SRAMへのアクセスで書き込みと読出しが競合（ハザード）しうるのは、書き込みと(a)読出しだけ、のはず
> (B)ただしこの読出し時のハザードは、VGA出力のチラツキ現象として観測されるはず。この現象は重心計算には無関係のはず。

まず説明する前にカメラ側のクロックをCCLK、ビデオ出力側のクロックをVCLKと定義します。
(A)についてはCCLKによるWriteとVCLKによるReadになります。ここでどのデータを優先するかについて明示しないと競合が発生した際にWrite側が破壊されるか、Read側が破壊されるかわかりません。

このようなことがありますので明示的に設定していないと、(B)として記載されているVGA出力のチラツキ現象として観測されるはず、とならない場合があります。

また確率が極めて低いとは思いますが、VCLK側のReadの始まりor終わりとCCLK側のReadの始まりor終わりのタイミングでアドレスまたはEnableまたはWrite信号のsetup/holdエラーが発生した場合SRAMの内容の破壊の可能性があるはずです。
こちらについてはめったに発生しないはずなので本件と関わりはなさそうだと思いますが発生する可能性はあります。

akita11, 2017-06-05:
なるほど。理解しました。ということは、SRAMのIPの設定を、WriteFirstにして試してみる、のがいいですかね。

watari3, 2017-06-05:
DRAMまたはSinglePortSRAMでの対応について記載します。

> ↑↑でDRAMを使う場合は工数が多そう、ということは理解しました。SinglePortSRAMを追加するリソースはありましたっけ？あ、でも、現行で、重心計算＆VGA出力用があわせてdepth=6bitなのを
>・二値化フラグ格納＆重心計算用のSP(depth=1bit)
>・生画像or二値化フラグ格納＆VGA出力用のTDP(depth=現行5bitだがこれより少なくてもOK)
に分けるだけなので、BlockRAMリソースとしては、それほど変わらない（＝大きな変更はないので工数が少ない）、という理解であってますか？

そもそもオリジナルデザイン、つまりILAなしの状態、であれば60%程度以下のSRAMしか使っていないはずです。
よってILAの設定を変えることで1bit程度であればSRAMを捻出できます。
また、上記に記載されている＆ご認識の通り現行のVGA出力用のTDPのうち1bitを重心計算専用に割り当てるでも構いません。

なおどちらもRTLを記述する、という工数では誤差の範囲内ですし、ILAの調整が必要だったとしても半日以下の工数(最短1時間程度)で実現できると思われます。

またご理解されているようにDRAMの場合以下のような回路を実装しないとならず、多少時間がかかります。

・MIG(DRAMのPhisical PHYと初期化シーケンスロジック)の実装
・DFI(DRAM PHYとユーザー回路を繋ぐInterfaceの仕様)に合わせた信号生成回路の実装
・Line Memory or FIFO Bufferの実装
・DRAMアドレス生成回路の実装
・ピン配置確認及びXDCの準備

watari3, 2017-06-05:
>なるほど。理解しました。ということは、SRAMのIPの設定を、WriteFirstにして試してみる、のがいいですかね。
別でも記載しますが、4箇所の修正でほぼ安定するようになりますが、上記修正をしていないと、たまに誤動作している、となると思われます。
という訳ですのでWriteFirst修正をお願い致します。

akita11, 2017-06-05:
関連して1つ確認をさせてください。（質問したつもりでしたが見当たらないのでしていなかったようです）
SRAMからの読出しを行うのが、VGA読出しと重心計算読出しの2つがありますが、この両者が競合することはありえますか？
（私の理解では、SRAMが2バンクあって、VGA読出しはカメラ書き込み側バンク、重心計算読出しはその逆側バンクなので、VGA読出しと重心計算読出しは競合することはありえない、と理解していますが、これで正しいですか？）

akita11, 2017-06-05:
とりあえずメールでいただいた4点の修正＋WriteFirstに変更して、動作ためしてみます。

watari3, 2017-06-05:
> SRAMからの読出しを行うのが、VGA読出しと重心計算読出しの2つがありますが、この両者が競合することはありえますか？

そこそこの確率で発生するはずです。

以下理由。

重心計算はFVALの立ち下がりをトリガーに計算を開始し、Y方向のサイズ[cycle]かけてSRAMにアクセス。このSRAMアクセスではアドレスが0からY方向のサイズ-1まで変化する。

カメラ側のフレーム周期とVGA側のフレーム周期が異なるかつカメラ側のフレーム周期が早いため、この２つのフレーム周期の最小公倍数時間後、逆バンクアクセスが成り立たなくなり、そのカメラ側の1フレーム分の１周期のFVALの立ち下がりからしばらく経過したところでアクセスの衝突(競合)が発生します。

これはほぼ同じ周期であっても２つの最小公倍数時間後に衝突(競合)が発生するので、回避するには入力のフレームと出力のフレームを揃える必要があります。(*1)

しかしながらカメラのフレームレートをVGAのフレームレートよりかなり大きくしているため回避出来ません。(*2)

*1)
フレーム同期処理(GENLOCK制御のような処理)を行い、VGAの出力フレームに揺らぎを与えることで競合を回避できますが(*2)の条件があるためフレーム同期不可となるはずです。

akita11, 2017-06-05:
なるほど、（だいたい）理解しました。これはまずいな・・・
ちなみに逆バンクアドレスが成立しない状態での、SRAMの読み出しアドレスは、実際にはどちらになりますか？VGA出力側と重心計算側の両方からアクセスをしようとしても、実際にSRAMに与えられるアドレスは、どちらかですよね。

VGA出力のほうが優先度が低い（確認用なので）ことを考慮すると、
VGA出力と重心計算が、同一バンクに同時にアクセスをしようとした場合は、重心計算のほうを優先させる（VGA出力側の読み出しを無視する）ことができれば、この問題は解消できると思うのですが・・・

akita11, 2017-06-05:
昨日あげられた修正点（4点＋WriteFirst）を行って動作させて見ました。SX/SYの入れ替わりは（当然ながら）解消されましたが、すべて'0"の行が（ほぼ）交互に出てくる現象は変わりませんでした。これの原因として、考えられることはありますか？
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
あともう1つ、これとは無関係そうな現象をみつけたので、別issueたてます。

watari3, 2017-06-05:
>ちなみに逆バンクアドレスが成立しない状態での、SRAMの読み出しアドレスは、実際にはどちらになりますか？VGA出力側と重心計算側の両方からアクセスをしようとしても、実際にSRAMに与えられるアドレスは、どちらかですよね。

これは運任せになるはずです。

>VGA出力のほうが優先度が低い（確認用なので）ことを考慮すると、
>VGA出力と重心計算が、同一バンクに同時にアクセスをしようとした場合は、重心計算のほうを優先させる（VGA出力側の読み出しを無視する）ことができれば、この問題は解消できると思うのですが・・・

TOP層にあるgrav_sel_enをVGA側からのSRAMアクセス禁止信号に利用すれば可能です。

完璧を求めるのであれば下記のどちらかで対策できそうです。
Plan 2)の実装が簡単ですが、時々(or稀に)アクセスエラーが発生するはずです。
Plan 1)ではCCLKクロックでVSIZE+α[cycle]アクセス禁止が発生しますので、その間VCLKクロックで0が出力されます。

Plan 1)
・重心処理ステートマシーンにSRAMアクセス禁止信号を出力するステートを2つ追加（クロック周波数の違い、メタステ対策を考慮した回路とすること）
・VGA側に上記信号をメタステ対策して受け取る回路を追加
・上記VGA側クロックに同期した信号を用いてSRAMのアクセスを停止(CSを落とす)

Plan 2)
・CCLKクロック同期のアドレス信号をメタステ対策してVCLKクロックで受信(バスを持っている信号なので正確に信号を受信することは難しい)
・VCLKクロックでアドレスの衝突検出回路を動作

watari3, 2017-06-05:
UARTから0が出力される件の詳細解析を行う必要があるのであればTOP層の下記信号とUARTの相関を取得していただけないでしょうか。

- cmr_field (CCLKクロック同期でSRAMアクセスバンクを決定)
- cmr_vsync (この立ち上がりをトリガーに重心処理を開始。CCLKクロック同期)
- mem_sel (VCLKクロック同期でVGA側のSRAMアクセスバンクを決定)
- grav_sel_en (CCLKクロック同期で、これがHighの間重心計算を実行)
- start_trig (CCLKクロック同期。UARTのbpsの8倍のクロックで受信できる信号を出力。UART IFの出力開始信号として使用)

これらの関係からおおよそ何が原因か見えてくるはずです。

なお本件は、重心計算用にSP SRAMを用意する事で回避できます。

watari3, 2017-06-05:
衝突の発生頻度を下げる方法として、本当に必要なアクセス時以外CSを落とす(CCLK/VCLKどちらとも)、という対策案がありますが準備したほうがよろしいでしょうか。

なお現行デザインではオリジナルデザインと同様にフレームの切り替わりでCSを変更しています。
(必ずどちらかのSRAMのCSが有効になる)

ご意見を伺いたく。
ご回答願います。

akita11, 2017-06-05:
上記Plan1で、VCLKがとまる、とのことですが、HSYNC/VSYNCは影響を受けますか？影響を受けないのであれば、画面表示の同期信号は現行通りで、ところどころの画素がズレる、ということになりますよね。アクセスできなかった画素に対しては、skipするようにできれば、例えば1234の順の画素値が1224、のように(3のところがアクセスできなかった)なって、VGA表示上はそれほど影響がない、と思えます。この方法が一番よさそうに思えますが、どんなもんでしょう。

akita11, 2017-06-05:
改めていただいた情報を理解しました。
SRAMを重心計算用とVGA出力用を分けるのが、
結果として早くて確実、な気がしてきました。
この方針での修正をお願いしてよろしいですか。
VGA出力用の方のdepthは、リソースの許す限り、でいいです。
また重心計算用と分けるので、ニ値化時と生画像出力時のメモリは分けず、
カメラからの書き込み時に、ニ値化するか生画像か、をvgaout_modeで切り替えればいいですよね。

>

watari3, 2017-06-05:
>上記Plan1で、VCLKがとまる、とのことですが、HSYNC/VSYNCは影響を受けますか？影響を受けないのであれば、画面表示の同期信号は現行通りで、ところどころの画素がズレる、ということになりますよね。アクセスできなかった画素に対しては、skipするようにできれば、例えば1234の順の画素値が1224、のように(3のところがアクセスできなかった)なって、VGA表示上はそれほど影響がない、と思えます。この方法が一番よさそうに思えますが、どんなもんでしょう。

Plan 1)のVCLKが止まるとは、CCLKクロックでVSIZE時間/VCLKのクロック周期+α　時間SRAMアクセスが止まることを指しています。
この時間の間

a) 前のデータを保持する
b) 0を出力する

のどちらかを実装することで見え方が変わります。
なおVGAのタイミング生成回路とSRAMアクセスは独立していますのでHSYNC/VSYNCが止まるorおかしくなることはありません。

watari3, 2017-06-05:
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

上記の件承知しました。

以下備忘録

- 重心計算用のSRAMはSP SRAMとして別途用意する(これを行わないとRead同士の衝突は回避できない)
- CLctrl内でvgaout_mode信号を見て何を書き込むか(2値化データ or Rawデータ)を決定する
- VGA側はSRAMのデータを何も考えずに出力する

akita11, 2017-06-05:
はい、お願いします。あと確認ですが、これを行っていただくならば、例のUARTから'0'や異常に小さな値が出てくる原因をみるために内部信号を観測する、のは、いまは行わなくてもよいですよね。

watari3, 2017-06-06:
RTL変更前にTOP.v 214行目に不具合の原因となりうる記述を見つけました。
この修正したものをpushしておきます。(先日ご連絡した4箇所の修正 + 本修正を実施したもの)
RELEASE_CANDIDATE_1 tagのデザインを用いてご確認をお願い致します。

akita11, 2017-06-06:
こちらは、SRAMをVGA出力用と重心計算用で分離したものですか？
もしそうでなければ、競合が起こりうる回路での動作チェックはあまり意味がないと考えますが、それでも動作チェックを行った方がいいですか？

watari3, 2017-06-06:
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

上記の仕様確認。
そもそも重力計算用のSRAMを別途用意する場合、ダブルバッファ用のSRAMは不要ではないでしょうか。

もし不要であれば、現状のILAを実装(BRAM使用率約30%)したとしても、色深度8bitでVGA出力かつ重力計算用SRAMも実装可能です。

本件について回答いただければ幸いです。

akita11, 2017-06-06:
いえ、現行の方法では、重心計算用のRAMは2バンク必要なはずです。
重心計算を、FVALがおわったところからY方向の累算を開始し、その後X方向に累算しますよね。これが480(Y)+640(X)=1120クロック。
これがVブランクの期間中に終わるのであれば、ご指摘のように2バンクは不要で、1バンクでOKです。このVブランク期間中に終わりますか？

終わらないのであれば、書き込み用と読出し用が別なので、2バンク構成必要です。

理想論を言うと、1行分の読み込みを行いながらY方向累算は1行ごとに実行できますので、
FVALが終わった時点で、Y方向の累算を終えることはできます。
残りのX方向累算をVブランク期間中に行う、という方法も、一応可能です。（アルゴリズム1)

さらに理想論いうと、カメラから画素ごとに値が送られてくるわけですから、
画素ごとに、S/SX/SYを累算して求めていき、FVALが終わった時点で、S/SX/SYの演算が終わっている、ということも、一応可能です。（アルゴリズム2）

ただこれらのアルゴリズム1とアルゴリズム2は、仕込みを始める前にご相談して、これらの方法も可能ですが、お任せします、とお伝えしていましたが、オリジナルのアルゴリズム（読出し後にY累算→X累算の順）に沿って実装します、と言われて、その通り実装していただいている、という経緯です。

2017年6月6日(火) 21:55 watari3 <notifications@github.com>:

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

watari3, 2017-06-06:
>重心計算を、FVALがおわったところからY方向の累算を開始し、その後X方向に累算しますよね。これが480(Y)+640(X)=1120クロック。
>これがVブランクの期間中に終わるのであれば、ご指摘のように2バンクは不要で、1バンクでOKです。このVブランク期間中に終わりますか？

カメラの最小Vブランク期間がわからないのでなんとも言えませんが、1120クロック=2H未満となり、一般的なビデオ信号(notカメラ信号)であれば計算は完了します。

今回はVGA出力用のSRAMを2つ削除(1bit分)し、重心計算用に2つ(ダブルバッファ)追加しています。
コードは最小限の修正としたく、前出の備忘録通りに修正はしていませんが機能等価となるよう修正しています。

watari3, 2017-06-06:
>こちらは、SRAMをVGA出力用と重心計算用で分離したものですか？
>もしそうでなければ、競合が起こりうる回路での動作チェックはあまり意味がないと考えますが、それでも動作チェックを行った方がいいですか？

下記の手順でご確認いただければ幸いです。

1) 6時代に重心計算用にSRAMを割り当てたデザインをpushします。まずはこちらで確認願います。
2) 1)の結果がNGの場合6/6に記載した信号をILAで確認願います。結果から不具合箇所を調査します。
3) お時間があるようでしたらRELEASE_CANDIDATE_1 tagのデザインで確認をお願い致します。(1)のRTL修正に根本的な間違いがあった場合)

akita11, 2017-06-06:
わかりました、その手順でやってみます。
「6時台」のcommitがあるブランチが見つからないのですが、
どのブランチですか？

watari3, 2017-06-06:
そうです。feature/calculate_center_of_gravityブランチの最新を利用ください。

なお基本修正ファイル1つ毎にコメントを記載し、何箇所かの修正をまとめてpushしています。

akita11, 2017-06-06:
↑をimplementして動作させてみました。
・以前のように、対象物が右端付近にあるときに、「すべて'0'ではなくて異常に小さな値」にならず、「すべて'0'」が出るようになった（対象物が左端や中央にいるときも同様）
・以前は、「すべて'0'」が、2～3回に1回だったのが、見ている限りは、ちょうど2回に1回（正常値と交互）に出るようになった。
まずは↑の2.の手順へ進めてみます。
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

akita11, 2017-06-06:
2.へ進んで、指定された信号をILAでみてみました。この部分を拡大してほしい、などがあればご指示ください。
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

akita11, 2017-06-06:
もう1個とってみました。横軸8000-28000あたりで「すべて'0'」の行、59000あたりから正常値と思われる値がUARTから出てきています。
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

watari3, 2017-06-07:
Typoを見つけ修正しました。
これで直るはずです。

もしこれでも直らない場合は以下の信号を追加してILAで測定してもらえないでしょうか。

・(TOP層にある)cmr_wea
・(TOP層にある)cmr_web

akita11, 2017-06-07:
ありがとうございます、これから試してまたご報告します

秋田
2017年6月8日(木) 6:45 watari3 <notifications@github.com>:

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

akita11, 2017-06-07:
実機動作確認しました。「すべて'0'の行」は現れなくなり、また対象物が右端のほうにあるときに異常にS/SX/SYが小さくなる現象も起こりませんでした。
得られたS/SX/SYから求めた重心の値は、対象物が静止している状態ではほぼ一定（±2程度）でした。
以上から、動作はOKそうです！

2017-06-08 7:28 GMT+09:00 Junichi Akita <akita@is.t.kanazawa-u.ac.jp>:

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

watari3, 2017-06-07:
では今晩になりますがfeature/cacl_gravity_of_centerブランチをmasterブランチにマージしfeature/cacl_gravity_of_centerブランチ及び関連するissue(issue #1 , issue #19 , issue #20 , issue #21 , issue #22 )をクローズすることにします。

この作業の後、tclによる環境構築(issue #8 ), MMCM IPの生成不具合(issue #17 ), Host IFの実装(issue #3)を取り組む予定です。

akita11, 2017-06-08:
はい、よろしくお願いします。個人的にはissue#3 が優先度高めだとありがたいです。残りの2つは、プロジェクト一式を移行した今となっては、現時点では問題になっていないので。。。

watari3, 2017-06-08:
修正完了したのでclose

Closed 2017-06-08.

Thread 22 (2017-06-05):

右端のほうでの重心計算処理

akita11, 2017-06-05:
撮影領域の左のほうや中央付近に対象物があるときは、正しい重心の値が求められているようになりましたが、右端付近にあるときに、S/SX/SYの値が、ときどき異常に小さくなる現象があります。
例えば以下のような二値化後の画像（カメラの撮影領域のほぼ右端に円がある）のときです。
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
このときの正しいと思われるS/SX/SYの値は、16進表記でそれぞれ、01000、0260000、007000付近です（得られるS/SX/SYの値から求めた重心や、同じ対象物を左に水平に移動させて画面中央付近にあるS/SYの値から推定）
これらの正しい値が求められるフレームもあるのですが、交互かそれよりやや低い頻度で、それぞれ00150、001700、0008000付近の値が出てくるようです。
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

ただこれは、別issueで報告していた、「すべて'0'の行が半分くらい交互に出てくる」現象と似ていて、
・対象物が中央付近にあるとき→すべて'0'の行が半分くらい
・対象物が右端にあるとき→00150、001700、0008000付近の行が半分くらい（異常に小さな値）
となる、とみることができます。

つまり、約半分くらいのフレームで、S/SX/SYが、「すべて'0'」または「異常に小さな値」となる、とみることができるわけですが、これの原因はわかりますか？
別issueの、SRAMアクセスのVGA読み出しと重心計算読み出しの競合、が原因のように思えます。

watari3, 2017-06-05:
なんとも言えませんが issue #21 と関係していそうです。
issue #21 でお願いした信号を測定していただけないでしょうか。

取り敢えず今晩何らかの対策でSRAMを捻出したSP SRAM追加版のデザインをpushします。
これまでの修正も一通りしてこちらからpushします。

【お願い事】
issueを記載される場合「別issue」という言葉を使うのではなく「issue #番号」で記載いただけないでしょうか。
githubの機能にて関連付けが行われ、振り返りの際に見やすくなります。

akita11, 2017-06-05:
わかりました、明日の朝イチで実機での確認・測定をしてみます。またご報告します。
（あとissue番号の件は失礼しました、了解です）

akita11, 2017-06-08:
解決したのでcloseいｓます。

Closed 2017-06-08.

Thread 23 (2017-06-11):

除算による重心計算

watari3, 2017-06-11:
除算による重心計算の仕様確認になります。
以下の仕様で進める予定ですがよろしいでしょうか。
また色は何色にしましょうか。(オリジナル　黒、提案　赤 or 設定で変更可能)

【仕様】
- FVALの立ち下がりをトリガーに計算された∑S, ∑Sx, ∑Syより重心を計算する
- 重心は内部レジスタで保持されマーカーとして○○色で出力
- 計算結果はHost I/Fから確認可能

akita11, 2017-06-11:
仕様の最初の2つは齟齬ありません。（色は・・・赤（で、れきれば十字マークがいいですね）計算結果の重心値のUARTからの出力フォーマットは別途（都合のいいように）定義してください（現実的には固定小数点ですよね）。また可能であれば、現行のS/SX/SY出力と、それから求めた重心値の出力、をコマンドで切り替えられるとベストですが、これはオプションとして。

仕様の3つ目の「計算結果はHosftI/Fから確認可能」の意味がわからないので、教えてください。

あと、各種設定のコマンドですが、面倒であればもっと短く1文字＋LF（例えば開始はS+LF、停止はs+LF、など）でもいいです（提案のままでもいいです：実装が楽なほうで）。

watari3, 2017-06-12:
「計算結果はHosftI/Fから確認可能」とは「計算結果をF/Fに保持しており、その値をHost I/Fを介して外部から値を読み出すことが可能」という意味です。

akita11, 2017-06-12:
理解しました。その機能はあるとうれしいです（が優先度は低めで結構です）。

watari3, 2017-06-18:
レジスタ表をアップデートしました。Host I/F側から各種値を確認することが可能です。

またDIV_28_20のIPを更新しましたので一度プロジェクトからファイル含め削除し再度tclを実行願います。

akita11, 2017-06-19:
実機動作させてみました。レジスタ0x01(VGAMODE)にwrして、raw/digitizedの切り替え（VGA出力で）はOKでした。
ただレジスタ0x02(THRESHOLD)を読み出すと常に0xffのようです。（以下では0x10を書き込んで、その後読み出したところ。0xffが読み出されている）ただVGAMODEをdigitized設定すると、そのwrしたTHRESHOLDに応じた二値化が行われているようです。(THRESHOLDを変えると二値画像も変わる）
また他のレジスタも、rdで読み出したところ、すべて読み出し値が0xffとなるようです。
書き込みはOKで、読み出しがNG、ということでしょうか。
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

ところでstart後にS/SX/SYが出力されていますが、これをQX/QY（割り算後の重心）に変更することは、けっこう手間ですか？（せっかく重心演算をFPGA側で行っているなら、それをUART出力するといいかな、と思ったのでした）

watari3, 2017-06-19:
>ただレジスタ0x02(THRESHOLD)を読み出すと常に0xffのようです。

すみません。レジスタを追加したところのcase文中のdefault文が抜けていたためsynthesis&implement後おかしくなっていました。
修正対応いたしました。

>ところでstart後にS/SX/SYが出力されていますが、これをQX/QY（割り算後の重心）に変更することは、けっこう手間ですか？（せっかく重心演算をFPGA側で行っているなら、それをUART出力するといいかな、と思ったのでした）

デバッグしきれていませんが仮対応したものをpushしました。
レジスタ表のOUT_SELを変更して確認いただければ幸いです。

watari3, 2017-06-19:
トリガー信号の幅問題を修正しました。(異なるクロックドメイン)

watari3, 2017-06-26:
issue #25 より

>1点だけ確認をさせてください。OUT_SEL=1としてS/QX/QYをUART出力しているときのそれぞれのビット数は、OUT_SEL=0でS/SX/SYのときと同じでしょうか。とすると、QX/QYは整数部分のみの出力、でしょうか。（ちなみにですが、これを小数部を含む書式に変更することは、けっこう手間でしょうか？）

ご認識の通りQX, QYは整数部のみ出力しています。
現在除算回路は商と余りを算出するようになっています。
小数部を含む形への変更は容易ですが、仕様を確認させてください。

- 除算結果を商と余りを算出する→小数部を含む商を算出するに変更
- 出力結果はどのように出力するか？現行のアスキー文字を出力するを保持 or バイナリー出力(その場合はUARTを7bitから8bit出力に変更します。)
- アスキー出力の場合どのようなフォーマットで出力するか？
- 結果出力にどのくらいの時間をかけてもよいか

以上、ご回答の程よろしくお願いいたします。

akita11, 2017-06-26:
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
例えば現行でSXの部分は28bit(7桁)ですよね。
QXは最大で640なので整数部は10bit。キリがわるいので、
整数部=12bit（3桁）、小数部16bit（4桁）
の固定小数点、はいかがでしょう。

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

watari3, 2017-06-26:
>QXは最大で640なので整数部は10bit。キリがわるいので、
>整数部=12bit（3桁）、小数部16bit（4桁）
>の固定小数点、はいかがでしょう。

除算IPの仕様上小数部は20bitとなりますが、上位16bitのみ使用で問題ないでしょうか。

akita11, 2017-06-26:
>
> 除算IPの仕様上小数部は20bitとなりますが、上位16bitのみ使用で問題ないでしょうか。
>
はい、もちろんそれでOKです。

watari3, 2017-06-26:
実装完了しpush済み。
レジスタ表をUpdateし小数部もレジスタアクセスにて確認可能。

watari3, 2017-06-26:
1つ質問ですが除算で0による除算を行った場合何かしらの情報を出力する必要はありますか？
現状だと商がFFF、小数部が不定(値未定)になります。

akita11, 2017-06-26:
その仕様のままでokです

watari3, 2017-06-27:
失礼しました。pushが一部抜けていました。
こちらでご確認ください。

akita11, 2017-06-28:
確認しました、S/QX/QY出力OKですので、本件closeします。

Closed 2017-06-28.

Thread 24 (2017-06-14):

画面が少しずれる？

watari3, 2017-06-14:
TMG_CTRL.vのhcount, vcountの意味を取り違えてVGAout.vで利用しているためX方向で画面のズレが生じる記述になっている。

TMG_CTRL.vのhcount, vcountとは別にdeでカウントアップする位置情報を表す回路を追加し、配線をそれに変更すること。

watari3, 2017-06-15:
修正しcommit&push済み

akita11, 2017-06-19:
いま論理合成かけていますので動作させてから報告します。

akita11, 2017-06-19:
こちらを使って動作させてみました。
・rdコマンドでレジスタ値を読むのは正常そう（書き込んだ値と同じものが読み出される）
・CURSOR_MODEのCURMD=1としても、画面上ではカーソルを確認できない（確認ですがカーソルONのときは、VGA出力モードがdigitized/rawのいずれでも表示されますか？digitizedのときのみ？）
・CURSOR_MODEのOUT_SELを1とすると、start後にUARTからこんな感じのデータが出てくる。ところどころ0-9/A-F以外の文字が出ている。
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
・OUT_SEL=0としてstartしたときも、ところどころに同様の文字がはいる（いずれも各行の最初の4-5文字だけっぽい）
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

watari3, 2017-06-19:
お時間ありましたらTOP.vのsum_s, sum_sx,sum_sy, quotient_sx, quotient_syの値を観測していただけないでしょうか。

akita11, 2017-06-20:
とりあえずILAの構成を8bitごとに観測するように変更して、リソースがゆるすだけ観測してみます。また報告します。
なお再度の念のための報告ですが、S/SX/SYの値そのものは正常そう（＝PCでこれらの値から求めた重心座標は、実際にカメラに映っている対象物の重心と一致している）です。

akita11, 2017-06-20:
いくつかとってみました。他に観測すべき信号があればご指示ください。（UARTの出力トリガーをみて、それをトリガーとして観測した方がいいのかな・・・）
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

watari3, 2017-06-20:
>・rdコマンドでレジスタ値を読むのは正常そう（書き込んだ値と同じものが読み出される）

Host I/Fについては完成したと判断し関連issueをcloseしました。

>・CURSOR_MODEのCURMD=1としても、画面上ではカーソルを確認できない（確認ですがカーソルONのときは、VGA出力モードがdigitized/rawのいずれでも表示されますか？digitizedのときのみ？あと、カーソルの形状は赤十字？赤点？）

現状digitized時のみ表示される仕様です。
カーソルの形状は小さい赤十字でしたが見えにくいので赤十字に変更しました。

>・CURSOR_MODEのOUT_SELを1とすると、start後にUARTからこんな感じのデータが出てくる。ところどころ0-9/A-F以外の文字が出ている。

該当回路間でメタステ対策が必要とは思っていないのですが、下記結果よりメタステが発生していると判断し対策を入れました。

修正版のRTLは6/21 AM7:00頃までにpushします。

watari3, 2017-06-26:
動作確認が取れた(issue #25 )ので本件close

Closed 2017-06-26.

Thread 25 (2017-06-19):

重心計算結果のVGA出力上の表示

akita11, 2017-06-19:
求めた重心位置を、VGA出力上に赤の十字で表示する（この機能は未実装？）

watari3, 2017-06-19:
サポートしているつもりですが、CURSOR_ENの設定を変えても変化ないですか？

このあたりテストベンチでは確認しづらく実機の写真を送付いただければ幸いです。

akita11, 2017-06-19:
失礼しました、CURSOR_ENというレジスタで、表示ON/OFFを切り替えられるのですね。
これをONにしたところ、モニタ上に赤マークは表示されるのですが、ちょっと位置がずれています。
https://www.dropbox.com/s/tav4p8dlwoxjheh/2017-06-20%2007.37.15.jpg?dl=0
（この写真の付近中央付近の赤丸内）
対象物（円図形）を動かすと、それに応じて（同じ向きに）赤マークも動くのですが、動き幅が小さいように思えます。感覚的には、赤マークの移動量が対象物の移動量の半分程度、でしょうか。（ということは重心の座標が実際の1/2になっている？）

watari3, 2017-06-19:
すみません。写真見ても赤のマーク見つけれませんでした。
（小さすぎて見えない？）
もしよろしければ6/20 AM 7:00頃のデザインでOUT_SELという設定を変更することでUART上に∑S, ∑SX,∑SY出力と∑S, QSX=(∑SX/∑S), QSY=(∑SY/∑S)の切り替えが出来ますのでこれで確認していただけないでしょうか。

watari3, 2017-06-19:
また位置がずれている件、issue #24 と関連しているようにも思っています。
issue #24 に対してコメントいただけないでしょうか。（以前のものと最近のものとで差があるか、など）

akita11, 2017-06-19:
赤マークの写真、こちらです。
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

なおstart後にUARTから出力されるS/SX/SYからPC側で求めた重心座標は、正しい位置のようにみえます。
issue #24 は、いま論理合成かけています、動作させた結果は追々。

watari3, 2017-06-19:
デバッグ用に6/20夜にVGA出力側にテストパターン生成回路を実装します。
これを用いて実機でバッグできる体制を作ります。

watari3, 2017-06-20:
この件原因判明しました。
修正版を6/21AM7:00までにpushする予定です。

akita11, 2017-06-20:
issue #23 、issue #24 とも関連するのですが、動作結果の報告です。
簡単にまとめると、
・重心計算（割り算）はOKそう
・VGA出力上に表示されるマーカの形状がおかしい（位置はOKそう）
・ところどころS/SX/SY出力値がおかしい

以下、詳細です。

まず動作させると、↓のような赤線が現れます。縦線が2本、うち1本は重心のX座標と一致しているっぽい。
https://www.dropbox.com/s/0spxvsmxdevlwv3/2017-06-21%2008.35.35.jpg?dl=0

その後、wrでCURMD=1（重心カーソルON）とすると、↓のような黒い小さい正方形(2x2画素程度)が現れます。この位置は対象物の重心に一致していると思われ、対象物を移動させると、それに追随してこの小さい正方形も重心位置で移動します。
https://www.dropbox.com/s/xzrr9uug2moa5xa/2017-06-21%2008.34.32.jpg?dl=0

以上から、割り算での重心計算はOKそうに思えるのですが、その位置の表示方法がおかしいのではないかと推測されます（赤線の形状がおかしい、黒い正方形は何か？）

またS/SX/SY出力をみてみると、ところどころ（感覚的には10行に1回くらい、ただし間隔は不均一）に、スペースが現れています。（スペースが入っていない行は、正しいS/SXSYと思われます＝PC側で割り算して重心を求めて表示させると対象物の重心位置と一致しているっぽい）
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

watari3, 2017-06-21:
仕様を確認したく下記について回答願います。

【仕様確認事項】
- 画像の外枠((0,0)-(639,0)-(639,479)-(0,479)で囲まれる四角形の外側)に何らかの線を表示する必要があるか
→オリジナルは黒線を表示
- 重心を中心に上下1ピクセル、つまり3x3ピクセルの四角形部分を黒色にする必要があるか
→オリジナルは3x3ピクセルの黒四角を表示
- 重心を中心に赤十字(横方向640ピクセルの線と縦方向480ピクセルの線。交点は重心)のカーソルを表示
→今回実装(バグを修正すること)
- カーソルはdigitize/rawとも表示する
→オリジナルはdigitize時のみ

akita11, 2017-06-21:
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
どちらでもよいです（あってもなくてもよい）

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
これを要望します。

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
両方とも表示、でお願いします。

watari3, 2017-06-21:
カーソル表示するようRTLを変更しました。

またASCII形式の16進数に対してエラー検出回路を作りましたがデバッグ出来ていません。
TOP層のrslt_*_ffがそれに当たります。
実機確認する際この信号を含めて観測していただけないでしょうか。

akita11, 2017-06-21:
えと、「エラー検出回路」を入れてエラーが起こったら回避するのではなく、本来は起こらないはずのエラー（0-9/A-F以外の文字が送られたら）の原因を摘む、のが順当ではないかと思うのですが、いかがでしょう。

あと実機確認する際に観測するべき信号をおしえてください。

watari3, 2017-06-21:
説明し直します。
「エラー検出回路」はあくまでエラー検出であってエラーの原因を掴むためのものです。
一応コードを書きましたが時間切れで十分なSimulationが出来ていません。
このことを「デバッグ出来ていません」と表現しました。

TOP層に下記信号があります。

- rslt_s_ff
- rslt_sx_ff
- rslt_sy_ff
- rslt_qsx_ff
- rslt_qsy_ff

それぞれS, SX, SY, QSX, QSYのIsXDIGIT(16進数のキャラクタかどうか判定する信号)結果になります。
現状Simulationしていないのと等価なのであまりあてになりませんが何かありましたらこの信号を観測ください。

akita11, 2017-06-21:
ああなるほど。そういう意味ですね。わかりました。この5つの信号を観測するだけでよいですか？

watari3, 2017-06-21:
6/22 AM 7:00頃のRTLであればrslt_s_ff, rslt_sx_ff, rslt_sy_ffをILAに結線してあります。
エラーの症状に合わせて接続していただけないでしょうか。

自信がないのでIsXDIGITを含むエラー検出回路が動作していないかもしれませんが...

akita11, 2017-06-22:
素朴な疑問なのですが、以前除算器を入れる前のときには、S/SX/SYは正常（このようにとこどころこ空白などは入らなかった）でしたよね。
で、その後除算器を入れたわけですが、いまUARTでみているのはS/SX/SYの値なので、除算器の動作とは無関係なはず、ですよね。
ということは、S/SX/SYにこのような空白などが入る現象の原因が理解できないのですが、これは起こりうることなのでしょうか（原因のめどはありますか）？

watari3, 2017-06-22:
記録の為に記載します。

演算回路のクロックとUARTの出力回路のクロックは非同期です。また発生している症状からバス信号の受け渡しをミスしている様にみえます。
このエラーが発生した時のある信号の位相関係が分かれば対策出来ると思っています。
おおよそこれだろうという信号の目星はついていますので裏取りしたい、という事になります。

akita11, 2017-06-22:
的を外しているかもしれませんが、送信データをダブルバッファ構成にすれば解決されたりしませんか？（つまり送信中に結果の書き込みがおこっても大丈夫なように）

akita11, 2017-06-26:
動作確認してみました。カーソル表示、S/SX/SYのところどころの文字化け、いずれもOKそうです。
1点だけ確認をさせてください。OUT_SEL=1としてS/QX/QYをUART出力しているときのそれぞれのビット数は、OUT_SEL=0でS/SX/SYのときと同じでしょうか。とすると、QX/QYは整数部分のみの出力、でしょうか。（ちなみにですが、これを小数部を含む書式に変更することは、けっこう手間でしょうか？）

watari3, 2017-06-26:
動作検証し問題ないことが確認されたので本件 close
上記の質問に対しては issue #23 にて回答する。

Closed 2017-06-26.

Thread 27 (2017-09-10):

Support SPARTAN6

watari3, 2017-09-10:
SPARTAN6 LX150Tにコードを移植する。

feature/upport_SPRTAN6

にて移植作業を開始しています。

このブランチで確認願います。
但し3つのIPの移植及び修正、Linux版のISE用project file (design/ISE下)を環境に合わせる必要があります。

akita11, 2017-09-23:
とりあえずIPは、Kintex用のVivaoプロジェクトの中のIPをみながら、Spartan6用のをISE上で手動でつくってみます。あわせて制約条件などもトライしてみますが、詰まったら、またご相談させてください。

akita11, 2017-09-29:
↑の手順で、ISEで不足しているIPコアを、対応するVivadoプロジェクト内のIPコアの設定をみながら同じになるようにつくってみました。
・*.bmmがみつからない、といわれるのですが、これは何かわかりますでしょうか。（BlockMemoryのマップファイル、らしいの）
・これと関連するかもしれませんが、ためしにSynthesizeをかけると、::MEM_xmdf::xmdfInit"' のTclコマンドのエラー、が出るようです。
↓両方がわかるスクリーンショット
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

対応方法、わかればお願いします。

watari3, 2017-09-30:
bmmファイルはメモリに対する初期設定値ファイルです。

このファイルはROM化する場合やCPUのboot imageを配置する際に利用します。
今回はbmmファイルは不要ですので、使用しない設定で進めていただければ本問題解決します。

akita11, 2017-10-13:
本件、その後調べているのですが、CLK_DIVIDER_SPARTAN6.bmmがない、とでますが、CLK_DIVIDERとはどの回路のことでしょうか（探した範囲ではみあたらない）。CLK_DIVIDERという名前からして、本来BMMが必要となるブロックメモリっぽくないのですが・・・

watari3, 2017-10-16:
必要な修正などをまとめた資料を作りますのでしばらくお待ち下さい。
またISE WebpackではS6 LX150のみの合成などが出来ません。これ以外で合成できる環境構築しますのでしばらくお待ち下さい。

akita11, 2017-10-17:
ISE (Full version)を使える、以前使っていただいていてifdlkpをリモートで使ったほうが便利であれば、また使えるようにしますのでご連絡ください。

watari3, 2017-11-03:
進捗報告を兼ねて記載します。

ISEはWindows10非サポートなのでCentOS'7上で作業を進めています。
CentOS 7はNIC命名即がethX形式から変更されており、かつISEはeth0のみライセンス認証するためNIC名変更が必要です。

現在この作業をしていますのでしばらくお待ち下さい。

akita11, 2017-11-03:
わかりました、お手数をおかけします。私の方で行うべき作業があればあげてください。

watari3, 2017-11-04:
VGA_CLKについて質問です。SPARTAN6基板ではVGA_CLKはピン配置はR20でClock専用Pinをしようしていない、という認識で正しいでしょうか。

akita11, 2017-11-05:
はい、Spartan6基板では、VGA_CLK(VCLK)はR20です。

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

watari3, 2017-11-11:
ISE向けデザインを作成しreleaseディレクトリにTOP.binとして登録しました。
またfeature/support_SPARTAN6ブランチにRTLなどをコミットしておきました。

akita11, 2017-11-21:
確認おそくなりました、動作報告です。TOP.bin（サイズ:4,220,319バイト)を書き込んでみました。
- VGA出力のVSYNC/HSYNCがでていませんでした(VGAコネクタ端で常に1：FPGA出力は常に0ということか)
- UARTからは何も出力されず、TXD端子は常に0
取り急ぎ、報告です。原因などわかりましたら。。。

watari3, 2017-11-22:
基板の回路図及びPin配置に関する資料をfeature/support_SPARTAN6ブランチのdocディレクトリ下にあげていただけないでしょうか。
また資料がアップロードされていた場合その内容に不備がないか確認いただけないでしょうか。

クロック周り、ピン配置周りのミスだと思っているのですが確認を取りたく。

よろしくお願いいたします。

akita11, 2017-11-22:
doc/においてある、ピン配置（SC2_pin.xls）と回路図（schematic.pdf）は、手元にある最新版と合致していることを確認しました。またこれらのピン配置情報は、以前のプロジェクト（最初にお渡しした、当初は動いていた回路）でも使っていたものですので、ピン配置の情報に齟齬はないはずです。ピン指定の*.ucfで確認しましょうか？（プルリクがきているので、mergeすればよろしいですかね）

watari3, 2017-11-23:
feature/support_SPARTAN6ブランチのdesigns/syn/constraints/下のTOP_syn.ucfファイルをクロック周波数、ピン配置の箇所を確認いただけないでしょうか。

よろしくお願いいたします。

akita11, 2017-11-23:
確認します、少しお時間ください

akita11, 2017-11-23:
TOP_syn.ucf、確認しました。1か所だけ（これが原因のような気がする）。
SC2_pin.xlsxへの記入漏れが1か所ありました。
RSTN（リセット）がピン名K21です。（これはプルアップ）
 NET "RST_N" LOC = K21 | PULLUP;
これを*.ucfに記載していなかったので、0になって常時リセットがかかっていた・・・のかな？

watari3, 2017-11-23:
修正したucfファイル及びbinファイルをコミットしました。
こちらでご確認をお願い致します。

akita11, 2017-11-24:
早速書き込んでみましたが、現象変わらずですね・・・ふむ。（ちなみにK21がつながっているSW1が、SW押してないとき1、押すと0、なのは確認したので、プルアップの設定自体はきいてそうです）

akita11, 2017-11-24:
プロジェクト一式をいただいて、こちらで論理合成・配置配線かけてみる、というのは、できますか？

akita11, 2017-11-30:
いただいたプロジェクトを改めて配置配線までやってみて、念のためピン配置の結果も正しいことを確認しましたが、やはり症状は同じです。カメラからの信号がとれていなくても、少なくともVGA出力側のHSYNC/VSYNCは出るはず、ですよね。これがでないということは、リセットかクロック、でしょうか。

watari3, 2017-11-30:
まずはVGA_CLKとUART_TXを確認していただけないでしょうか。

- VGA_CLK <= 内部PLLで生成されたクロックをIO近傍のFFを用いてクロックとして出力
- UART_TX <= 通信時のみL/Hとなる。それ以外はH

これのどちらも動作しない場合は、仰られているとおりリセットまたはクロック(PLL)が悪いかと思われます。
PLLのリファレンスクロックがKintexの基板と異なりますのでここが怪しいですが、修正しているつもりです。
確認する場合はこちらからお願い致します。

akita11, 2017-12-01:
遅くなりました、確認しました。
VGA_CLK→常にL
UART_TX→常にL

まずはPLLを確認できるように、どこかの空きピンにクロックをそのまま出す、とかしてもいいですか？

watari3, 2017-12-01:
はい。まずはPLLから確認が良さそうです。

akita11, 2017-12-01:
その作業は私の方でやった方がいいですよね。

>

watari3, 2017-12-02:
デザインの作成は容易に出来ますし、ブランチを切ってこちらで作業はできます。
ピン配置をいただければデザイン作成いたします。

akita11, 2017-12-02:
そこまでのこでもないので、少しこちらでわかる範囲で試してみます

akita11, 2017-12-04:
TOP.vに、以下の二行を追加して、PLLで作っているクロックを外に出しました。
```
 BUFG i1(.I(clk_uart_x8), .O(JP[1]));
 BUFG i2(.I(cts_vga_clk), .O(JP[2]));
```
これに関連して、以下をTOP.ucfに追加しています。
```
PIN "i1.O" CLOCK_DEDICATED_ROUTE = FALSE;
PIN "i2.O" CLOCK_DEDICATED_ROUTE = FALSE;
PIN "i1.O" CLOCK_DEDICATED_ROUTE = FALSE;
PIN "i2.O" CLOCK_DEDICATED_ROUTE = FALSE;
PIN "m_CLK25M/m_CLKGEN_MMCM/clkout1_buf.O" CLOCK_DEDICATED_ROUTE = FALSE;
PIN "m_CLK_UART/m_DIV_CLK.O" CLOCK_DEDICATED_ROUTE = FALSE;
```
結果は、いずれも0のまま、でした。
以上から、PLLがちゃんと動いていないのではないか？と思うのですが、どんなもんでしょうか。

watari3, 2017-12-04:
今回のPLLですがCLKポートから50MHzの入力&常時クロック入力を期待しています。
またこのPLLですが外部からリセットも要求しています。

この２つの要求を満たすような基板でしょうか。
もしなっていないようでしたらRTLを変更します。

akita11, 2017-12-04:
CLKは常時50MHzです。RSTはボード上のタクトスイッチにつながっています。
ちなみにRSTは正論理ですか？(1でリセット？)
手動でこのタクトスイッチは押してなかったので、押して動作みてみます。

> ちなみにこれ、25MHzをつくるんですよね？
であれば1/2分周だけでよい、、、？

watari3, 2017-12-04:
PLLのRESET極性が逆のようでしたのでRTL修正しました。
こちらでご確認願います。

> > ちなみにこれ、25MHzをつくるんですよね？
> であれば1/2分周だけでよい、、、?

25MHzとUART用の50MHzをBUFGで出力したく2つの出力となっています。

akita11, 2017-12-04:
リセットの極性がぎゃくでしたか、なるほど。試してみます

akita11, 2017-12-04:
変更点を確認しました。CLK25M.vの中、ですね。手元で修正してためして、またご報告します。

akita11, 2017-12-09:
PLLのリセット極性を直して動作させて見ました。PLLの動作は大丈夫そうで、VSYNC/HSYNCもでています。カメラをつないでの動作は、またご報告します。

akita11, 2017-12-09:
カメラをつないで動作させてみました。
・VSYNC/HSYNCは正常にでていますが、画面の左端20画素分ぐらいしか表示されていない（残りはすべて黒）です。この表示内容は、カメラを動かすと、それにあわせて動いている、ようです（小さすぎるのと、以下のようにUARTでraw出力モードに変更できないので詳細は確認できない）ちなみにPLLでつくった25MHzをJP[1]にデバッグ用に引き出していますが、そこは25MHzが正しくでていますのでPLLはOKそうです。
・UARTが応答ないです（230400bps/7bitでrdコマンドを送ってもOKもNGも返らない）←TOP.ucfの記述ミスでTXとRXが逆だったためそれを修正しましたが、現象は同じでした。ちなみにこの修正により、TXピンは、FTDI-Basic未接続時にはH(3.3V)になりました。なおリセット直後は、UARTから座標データは出てきていません（Hのまま）
原因、思い当たる節ありますか？

watari3, 2017-12-09:
クロック周りが怪しいですね。
周波数とボーレートを確認しますので暫くお待ち下さい。

watari3, 2017-12-09:
UARTのクロック周り問題なさそうです。

UARTを分離してHOST IFと計算結果出力を独立させて内部解析しますか？
それともHOST IFのみ動作させるRTLに変更して内部の挙動を確認しますか？

akita11, 2017-12-09:
起動時(RST直後)には、カメラからの画像に合わせてSなどがUART-TXから連続してでてくるはずですよね。それがでてこないということは、カメラからのFVALなどを取りこぼしている、という可能性はありますか？
あ、でもVGA出力で、一部とはいえカメラ画像っぽいものが出ているので、FVALなどの取りこぼしはないですね。
あれ、それとも起動時はSなどはでてこないのでしたっけ。であれば、起動時に出てくるようにして、UART-TXの波形を見るのがいいのか。ちょっとやってみます。

akita11, 2017-12-09:
↑を確認しましたが、uart_swのRST時の初期値が0で、これはTOP.vでは
`assign  uart_out_data = (uart_sw) ? uart_host_data: uart_calc_data;`
となっているので、RST時にはSなどがUARTから出てくるはず、ですよね。これが出てこない(常にTXD=1)ということは、UARTのクロックですかね？（RSTの極性はあってますよね？）

watari3, 2017-12-11:
いいえ。
EYE_TRACKER_REG.vの67行目を見ていただければわかりますが、リセット後uart_swは1になります。
よってHOST通信ができるはずなんですが。

IP以外の部分は基本Kintex7 160Tと共通ですのでリセット周りの問題はないと思っています。

強いて言えばUARTを駆動するためのクロックがクロックラインを使用せずFFに供給しているので心配ですが、周波数が低いのでいまいちわかりません。

Post Simすればいいとは思いますが、Post SimするならできればC社のシミュレーターをLinux上で使用したいです。
ISE付属のシミュレーターでの経験ないので。

akita11, 2017-12-12:
ん？uart_swの初期値は0じゃないですか？以下のようにあります。
    DFF_REG   #( .DATA_WIDTH(1), .INIT_VAL(1'b0 ) ) m_UART_SW      ( .CLK(CLK), .RST_N(RST_N), .iWE(iWE_BIT[0]), .iD(iDATA[  0]), .oD(oUART_SW     ) );

akita11, 2017-12-12:
ためしにuart_swによらずに座標をTXDから出すように、以下のように書き換えてみました。
修正前：
```
    assign  uart_out_de   = (uart_sw) ? uart_host_de  : uart_calc_de;
    assign  uart_out_data = (uart_sw) ? uart_host_data: uart_calc_data;
```

修正後：
```
    assign  uart_out_de   = uart_calc_de;
    assign  uart_out_data = uart_calc_data;
```

TXDは常に1、でした。（カメラからの画像に応じてVGAモニタの映像は（左端の10画素分ぐらいだけですが）変化しているので、カメラからの信号はきているはず）
したがってUARTのクロック周りの問題ではないかと思うのですが、どうでしょうか。
Cadenceのシミュレータのほうがよければ、（逆に私が経験がないため）手順さえいただければシミュレーション行って作業しますが・・・

watari3, 2017-12-14:
ISEが要求するVerilogシミュレーターのバージョンなどを調べますのでしばらくお待ち下さい。

予想ですがIUS 9系か10系だったような気がします。
ご用意できそうですか？

akita11, 2017-12-15:
ISE内蔵のISimでも、ポストレイアウトシミュレーションできるみたいですが、これではだめですか？

NCsim/iusはちょっとわからないのですが、VDECで利用可能なCadenceツールはこちらです。ここにあるものであれば、データをいただいて私のほうでシミュレーションを実施することはできますよ。
http://www.vdec.u-tokyo.ac.jp/CAD/announce.html#intro

watari3, 2017-12-17:
UCFファイルを更新して合成してみました。
releaseフォルダーにあるTOP.binを用いて確認いただけないでしょうか。

akita11, 2017-12-18:
動作させてみましたが、現象は同じ（TXDは1のまま）、でした。
ちなみに手元で、以下のようにしてUARTのclkを外に出してみましたが、0のままでした。
```
    BUFG i1(.I(clk_uart_x8), .O(JP[1]));
    BUFG i2(.I(cts_vga_clk), .O(JP[2]));
```
i2のほうのcts_vga_clkは、ちゃんと25MHz（たしか）がでていますが、i1のほうのclk_uart_x8は0のまま、でした。
TOP.vを見る限り、このclk_uart_x8はCLK_DIVIDEで作っていて、その中身のCLK_DIVIDER.vは、特に問題がなさそうに見えるのですが・・・というところで、いまのところ手詰まりです。

watari3, 2017-12-18:
Clockを分周するのをやめてClock Enableを生成する回路に変更します。

修正版が出来るまでしばらくお待ち下さい。

watari3, 2017-12-20:
UARTクロック周りを修正したデザインおよびTOP.binをpushしました。

ご確認ください。

akita11, 2017-12-21:
こちらのTOP.bin、動作させてみましたが、現象変わらず（UARTのTXは常にH）でした。ちなみに以前はVGA側に左側に少しだけ出ていたカメラ画像も出ていなかった（カメラを動かしたりして見てはいない）です。

akita11, 2017-12-21:
ソースコードもpushしていただければ、手元でUARTのCLKを外に出してみたりできるので、お願いできすか。

watari3, 2017-12-21:
TOP.binと同様にソースコードもpushしてあります。
ご確認願います。

akita11, 2017-12-25:
support_SPATAN6ブランチを一式DLして、ためしてみました。
前回と同様にclk_uart_x8をJP0に出して確認したところ（それができるようにTOP.vとTOP.ucfを少し修正）、そこには1.8MHz程度のクロックがでていましたので、UARTクロックは大丈夫そうです。
ただTXD、RXD、いずれも0のまま、でした。

watari3, 2017-12-25:
今回の修正でUART関連回路は「分周クロックを使用使用する仕様」から「SYSTEM Clockと分周クロック周期と同じ1パルス信号を使用する仕様」に変更しています。

報告された結果だとどこかでF/Fが消えたか、修正不足のようです。
下記を試していただけないでしょうか。

1 clk_uart_x8_ceも観測していただけないでしょうか。
2 TOP.vにてclk_uart_x8_ceが接続されているモジュールのUARTクロックをclk_uart_x8に、clk_uart_x8_ceの部分を1'b1に変更することで分周クロックを使用する仕様に変更になります。こちらも確認いただけないでしょうか。

watari3, 2017-12-25:
上記全て実行して変化なしなら以下の作業をする予定としています。

1 ISEのisimにてnetlistシミュレーション
⇒Windows10環境しかありませんのでVM上(*1)かLinux上で実施します。
2 CadenceのIUS(Incisive Unified Simulator)またはIES(Incisive Enterprise Simulator)にてnetlistシミュレーション
⇒やり方をお教えしますがカット＆トライになりそうです。

*1)
Windows10上でSpartan 6向けISEを実行する場合は下記を利用ください。
公式サポート版です
https://www.xilinx.com/support/download/index.html/content/xilinx/en/downloadNav/design-tools.html

akita11, 2017-12-26:
↑↑の1.は、これから試します。
また2.は、例えば
```
    UART_TX_CORE #( .OVER_SAMPLING(8) )    m_UART_TX_CORE( .CLK(bufg_clk /*clk_uart_x8*/), .RST_N(RST_N),
                .iCLK_CE(clk_uart_x8_ce),
```
とあるのを、
```
    UART_TX_CORE #( .OVER_SAMPLING(8) )    m_UART_TX_CORE( .CLK(clk_uart_x8), .RST_N(RST_N),
                .iCLK_CE(1'b1),
```
と変更する、ということですよね？

akita11, 2017-12-26:
↑を試してみました。
1.は、clk_uart_x8_ceはつねに0、でした。
2.の修正をしたところ、UART-TXからそれらしいデータは出てきました。
https://gyazo.com/b01a55d7d6f6d32b1cc0e19526d9270e
UART経由のレジスタの読み書きも大丈夫そうです。https://gyazo.com/4e240f072dcef0285414a97f3a5c67d2

VGAモニタに表示されるカメラ画像は、左側数10画素分だけ、というのは変わっていません。今後はこの点の原因究明と対処、に進めますでしょうか。

watari3, 2017-12-26:
> VGAモニタに表示されるカメラ画像は、左側数10画素分だけ...

お手数ですが後々issueを見たときにわかるよう症状がわかる写真付きで別issueを立てていただけないでしょうか。

akita11, 2017-12-27:
本件、年明けに撮ります、少しお時間ください

watari3, 2017-12-29:
上記実験で使用したデザインになるよう修正を行いpush済み。
これを起点にfeature/issue29ブランチでカメラ画像取得不良の修正を行う。(issue #29)

Thread 28 (2017-12-15):

ときどき縦縞が現れる

akita11, 2017-12-15:
以前のKintex7版のほう、順調に動いているのですが、ときどき、以下のような縦縞が入ることがあります。
https://www.dropbox.com/s/dbvn3w914u5pg6q/2017-12-15%2017.46.34.jpg?dl=0
一度入ると、なかなか消えず、カメラ、FPGAの電源を入れなおして、消えることもあれば、消えないこともあって、という感じです。なんとなくですが、ずっと使っていて温度が高くなると現れやすいような気もします（気のせいかもしれない）。また対象物を静止させた状態でも、重心位置は不規則に、かなり大きく（±30画素以上）動きます。
画面を見る限り、カメラからの画素データの取りこぼし（スキュー）のような気もするのですが、心当たりありますか？

watari3, 2017-12-17:
温度条件があるかも、ということであればVivadoからFPGA内部にあるXADCをJTAGからアクセスし内部温度を観測していただけないでしょうか。

後ほど参考になる資料などのURLを記載いたします。

akita11, 2017-12-19:
あ、温度はそれほど疑っていませんし、外部から温度を測ることで、だいたいのめどはたてられますので、XADCへのアクセスまでは不要です（やることがオーバースペック）。ただ、原因になりうるかな？という助言はいただければ。

akita11, 2017-12-20:
本件、今回はなかなか元に戻らずに困っています。ためしに、以前使っていた別のカメラ（データの出力形式は同じ）でも、同じ現象がでます。1列ごとに画像ありとなしの縞、のように見えるので、カメラからのデータの書き込み時のインターリーブ（バンク切り替え）の問題（スキュー？）かな、と思うのですが、心当たりありませんか？

akita11, 2017-12-20:
いや、違うな。バンク切り替えはフレーム単位（奇数と偶数）なので、このように画面内の1列おきの縞の原因ではないですね。とすると、カメラからのデータか。1回あたりLとRの2バイトのデータがくるので、CLctrl.v内で
```
                    oMEMIN_1[i  ] <= iDATA_L[7];
                    oMEMIN_1[i+1] <= iDATA_R[7];
```
のように、奇数列と偶数列をいっしょに書き込んでいるので、縦縞にはなりえないはず、ですか。
改めてHDLをよむと、カメラからのDATA_L/Rを、INP_CAMERA_DATAをとおして、CLKに同期させてからcmr_data_l/rにして、これがCLctrl.vにはいっていますよね。ここでスキューってありえませんか？

akita11, 2017-12-20:
ためしに、INP_CAMERA_DATAでのCLK同期をせずに、DATA_L/Rを直接cmr_data_l/rにassignしてみたところ、奇数列と偶数列に起因する縦縞は消えました。ただちょっと画像があやしいので、これはこれでマズいのでしょうが・・・一応経過報告です。

akita11, 2017-12-20:
もうちょっと詳しくみてみました。ついでにlvalなどもCLK同期をとらずに直結してみました。縦縞が出るときもあれば、同じように縦縞が出ないときもある・・・という感じです。↑の、縦縞が消えた、というのは、そういうこともある、ということのようです。いまはまた縦縞が出ていて、電源入れなおしなどをしても消えません。
ちなみに重心のY座標は、対象物が静止していればほとんど変わりません。この現象も、２画素分のデータをセットでメモリに書き込むときに、どちらかが抜けている（ことがある）のが原因ではないか、と推測する根拠です。
以上から、やはりスキューっぽいのですが、なにか心当たりありますか？

watari3, 2017-12-20:
本件feature/support_host_ifブランチの話として進めます。

- INP_CAMERA_DATA => CLctrl
こちらは同期回路となっています。バススキューがあったとしてもsetup/hold errorが無ければ問題ありません。但し300ps以上のクロックジッターがあった場合は別途調査が必要です。(タイミングマージンがあるのである程度は耐えれるとは思いますが)
- INP_CAMERA_DATAをやめてcmr_data_l/rにassign
INP_CAMERA_DATAは入力PAD付近にあるF/Fを使用させるためなどの理由で使用しています。
今回これを使用せず次の回路へ接続し結果が変化したことからIO周りのSetup/Hold問題の様に思われます。
なお今回IOの入力制約は与えておりません。外部デバイスのsetup/hold要件(or 出力delay情報)及びクロックジッター情報を提示いただけないでしょうか。
この情報を元に制約ファイルを修正すれば対応できると思われます。

watari3, 2017-12-20:
また実機でカメラ側のクロックと制御信号やビデオ信号の位相差をオシロスコープで測定し、このデバイスがセンターアラインで出力されているなら現状のまま、エッジアラインで出力されているのなら初段F/Fのクロックエッジを変更することで解決するかもしれません。

akita11, 2017-12-20:
詳細ありがとうございます、うーむ、オシロでみるにしても、手元のオシロは帯域不足で、そこまでのタイミングは観測できませんね・・・
カメラからの信号は、こちらのレシーバでシリパラ変換してから、FPGAにつながっています。
https://www.dropbox.com/s/dklopeaoasshi8y/DS90CR288.pdf?dl=0
こちらの2ページ目に、AC特性がのっていますが、これでわかりますか？

watari3, 2017-12-20:
AC特性確認しましたがセンターアラインで出力されているようです。
よってIO制約がついていなくても動作するはずです。

念のため後ほどxdcを修正し、commit/pushしておきます。

watari3, 2017-12-20:
xdcファイルに入力制約を追加しました。

watari3, 2017-12-20:
feature/support_host_ifリポジトリにxdcしかpushしておりません。
必要でしたら後ほど合成いたします。

ところで本件、電源電圧も気になります。
NSのLVDS Rx及びFPGAの電圧を確認していただけないでしょうか。

akita11, 2017-12-21:
いただいたxdcを使って、手元で修正していたINP_CAMERA_DATAは元に戻して、動作させてみましたが、現象かわらずです。また電源電圧(CLレシーバ、FPGAボード、ともに3.3V)をみてみましたが、安定しているようです（オシロのAC結合でみたところリプルは15mVp-p程度）。

watari3, 2017-12-21:
このXDCでタイミングエラーが生じていましたか？
もしエラーが無いのであればINP_CAMERA_DATAの入力クロックを反転したクロック(~CCLK)に変更して様子を見てください。
また電源電圧の件ですが、大丈夫だとは思いますがFPGAのコア電圧(1.2V?)も観測いただけないでしょうか。

akita11, 2017-12-22:
INP_CAMERA_DATAのCLKを以下のように反転してみましたが、現象は同じでした。
`    INP_CAMERA_DATA  #( .PIXEL_WIDTH(PIXEL_WIDTH) )    m_INP_CAMERA_DATA (.CLK(~CCLK), .RST_N(RST_N),  ...
`
またタイミングエラーっぽいものはみあたりませんでしたが、クロック制約に関するwarningはいくつか（ピンが見つからない、など）はありました。ログは以下です。

```
Vivado Commands
open_project C:/work/EyeTracker/designs/FPGA/project_1/project_1.xpr

 Scanning sources...

[IP_Flow 19-234] Refreshing IP repositories

[IP_Flow 19-1704] No user IP repositories specified

[IP_Flow 19-2313] Loaded Vivado IP repository 'C:/Xilinx/Vivado/2016.4/data/ip'.

launch_runs impl_1 -to_step write_bitstream -jobs 4

[Vivado 12-4149] The synthesis checkpoint for IP 'C:/work/EyeTracker/designs/FPGA/project_1/project_1.srcs/sources_1/ip/DIV_28_20_2/DIV_28_20.xci' is already up-to-date

 [Fri Dec 22 08:11:13 2017] Launched synth_1...

connect_hw_server

[Labtools 27-2285] Connecting to hw_server url TCP:localhost:3121

[Labtools 27-2222] Launching hw_server...

[Labtools 27-2221] Launch Output:

****** Xilinx hw_server v2016.4
  **** Build date : Jan 23 2017-19:37:29
    ** Copyright 1986-2016 Xilinx, Inc. All Rights Reserved.

open_hw_target

[Labtoolstcl 44-466] Opening hw_target localhost:3121/xilinx_tcf/Xilinx/0000128f12ff01

program_hw_devices [lindex [get_hw_devices xc7k160t_0] 0]

[Labtools 27-3164] End of startup status: HIGH

refresh_hw_device [lindex [get_hw_devices xc7k160t_0] 0]

[Labtools 27-2302] Device xc7k160t (JTAG device index = 0) is programmed with a design that has 1 ILA core(s).

display_hw_ila_data [ get_hw_ila_data hw_ila_data_1 -of_objects [get_hw_ilas -of_objects [get_hw_devices xc7k160t_0] -filter {CELL_NAME=~"m_ILA"}]]

 WARNING: Simulation object uart_out_data was not found in the design.

[Labtools 27-3304] ILA Waveform data saved to file C:/work/EyeTracker/designs/FPGA/project_1/project_1.hw/backup/hw_ila_data_1.ila. Use Tcl command 'import_hw_ila_data' or Vivado File->Import->Import ILA Data menu item to import the previously saved data.

[Labtools 27-2269] No devices detected on target localhost:3121/xilinx_tcf/Xilinx/0000128f12ff01.
Check cable connectivity and that the target board is powered up then
use the disconnect_hw_server and connect_hw_server to re-register this hardware target.

[Labtoolstcl 44-513] HW Target shutdown. Closing target: localhost:3121/xilinx_tcf/Xilinx/0000128f12ff01

Analysis Results
sources_1
[HDL 9-2216] Analyzing Verilog file "C:/work/EyeTracker/designs/src/rtl/TOP.v" into library work ["C:/work/EyeTracker/designs/src/rtl/TOP.v":1]

sim_1
[HDL 9-2216] Analyzing Verilog file "C:/work/EyeTracker/designs/src/rtl/TOP.v" into library work ["C:/work/EyeTracker/designs/src/rtl/TOP.v":1]

Synthesis
synth_1
[Common 17-1239] XILINX_LOCAL_USER_DATA is set to 'no'.

 Command: synth_design -top TOP -part xc7k160tfbg484-1

[Common 17-349] Got license for feature 'Synthesis' and/or device 'xc7k160t'

[filemgmt 56-147] Overwrite of existing file isn't enabled.  Please specify -force to overwrite file  [C:/work/EyeTracker/designs/FPGA/project_1/project_1.runs/synth_1/.Xil/Vivado-14740-ifdlwin0/MEM/MEM.dcp]

[HDL 9-2216] Analyzing Verilog file "C:/work/EyeTracker/designs/src/rtl/CALC_GRAVITY_Y.v" into library work ["C:/work/EyeTracker/designs/src/rtl/CALC_GRAVITY_Y.v":1]

[Synth 8-638] synthesizing module 'TOP' ["C:/work/EyeTracker/designs/src/rtl/TOP.v":17]

[Synth 8-256] done synthesizing module 'DET_EDGE' (1#1) ["C:/work/EyeTracker/designs/src/rtl/USER_LIB.v":92]

[Synth 8-689] width (10) of port connection 'addra' does not match port width (9) of module 'MEM' ["C:/work/EyeTracker/designs/src/rtl/TOP.v":251]

[Synth 8-4446] all outputs are unconnected for this instance and logic may be removed ["C:/work/EyeTracker/designs/src/rtl/TOP.v":478]

[Synth 8-3331] design EYE_TRACKER_REG has unconnected port iWE_BIT[31]

[Project 1-486] Could not resolve non-primitive black box cell 'CLKGEN_MMCM' instantiated as 'm_CLK25M/m_CLKGEN_MMCM' ["C:/work/EyeTracker/designs/src/rtl/CLK25M.v":24]

[Project 1-560] Could not resolve non-primitive black box cell 'DIV_28_20' instantiated as 'm_CALC_GRAVITY_Y/m_DIV_28_20_SX'. "C:/Users/akita/AppData/Roaming/Xilinx/Vivado/2" instances of this cell are unresolved black boxes. [C:/work/EyeTracker/designs/src/rtl/CALC_GRAVITY_Y.v:413]

[Device 21-403] Loading part xc7k160tfbg484-1

[Constraints 18-619] A clock with name 'CLK' already exists, overwriting the previous clock with the same name. ["C:/work/EyeTracker/designs/syn/constraints/TOP_syn.xdc":22]

[Vivado 12-508] No pins matched 'm_CLK25M/m_CLKGEN_MMCM/inst/mmcm_adv_inst/CLKOUT0'. ["C:/work/EyeTracker/designs/syn/constraints/TOP_syn.xdc":37]

[Vivado 12-627] No clocks matched 'OUT_VGA_CLK'. ["C:/work/EyeTracker/designs/syn/constraints/TOP_syn.xdc":43]

[Vivado 12-626] No clocks found. Please use 'create_clock' or 'create_generated_clock' command to create clocks. ["C:/work/EyeTracker/designs/syn/constraints/TOP_syn.xdc":43]

[Vivado 12-4739] set_clock_groups:No valid object(s) found for '-group [get_clocks OUT_VGA_CLK]'. ["C:/work/EyeTracker/designs/syn/constraints/TOP_syn.xdc":43]

[Project 1-498] One or more constraints failed evaluation while reading constraint file [C:/work/EyeTracker/designs/syn/constraints/TOP_syn.xdc] and the design contains unresolved black boxes. These constraints will be read post-synthesis (as long as their source constraint file is marked as used_in_implementation) and should be applied correctly then. You should review the constraints listed in the file [.Xil/TOP_propImpl.xdc] and check the run log file to verify that these constraints were correctly applied.

[Project 1-236] Implementation specific constraints were found while reading constraint file [C:/work/EyeTracker/designs/syn/constraints/TOP_syn.xdc]. These constraints will be ignored for synthesis but will be used in implementation. Impacted constraints are listed in the file [.Xil/TOP_propImpl.xdc].
Resolution: To avoid this warning, move constraints listed in ['Undefined'] to another XDC file and exclude this new file from synthesis with the used_in_synthesis property (File Properties dialog in GUI) and re-run elaboration/synthesis.

[Timing 38-316] Clock period '1000.000' specified during out-of-context synthesis of instance 'm_CALC_GRAVITY_Y/m_DIV_28_20_SX' at clock pin 'aclk' is different from the actual clock period '20.000', this can lead to different synthesis results.

[Synth 8-5546] ROM "oMEMIN_0" won't be mapped to RAM because it is too sparse

[Common 17-14] Message 'Synth 8-3331' appears 100 times and further instances of the messages will be disabled. Use the Tcl command set_msg_config to change the current settings.

[Synth 8-4471] merging register 'oVGA_B_reg[7:0]' into 'oVGA_G_reg[7:0]' ["C:/work/EyeTracker/designs/src/rtl/VGAout.v":158]

[Synth 8-5544] ROM "next_state" won't be mapped to Block RAM because address size (4) smaller than threshold (5)

[Synth 8-802] inferred FSM for state register 'state_reg' in module 'UART_RX_CORE'

[Synth 8-5818] HDL ADVISOR - The operator resource <adder> is shared. To prevent sharing consider applying a KEEP on the output of the operator ["C:/work/EyeTracker/designs/src/rtl/CALC_GRAVITY_Y.v":198]

[Synth 8-327] inferring latch for variable 'next_clear_reg' ["C:/work/EyeTracker/designs/src/rtl/CALC_GRAVITY_Y.v":140]

[Synth 8-3354] encoded FSM with state register 'state_reg' using encoding 'sequential' in module 'UART_RX_CORE'

[Synth 8-3332] Sequential element (oD_reg[1]) is unused and will be removed from module SUM_UNIT__4.

[Synth 8-3886] merging instance 'm_CALC_GRAVITY_Y/i_2/m_MATH_DIV_SX_CTRL/state_reg[2]' (FDC) to 'm_CALC_GRAVITY_Y/i_2/m_MATH_DIV_SX_CTRL/state_reg[3]'

[Synth 8-3333] propagating constant 0 across sequential element (m_CALC_GRAVITY_Y/i_2/m_MATH_DIV_SX_CTRL/\state_reg[3] )

[Synth 8-5578] Moved timing constraint from pin 'm_CLK25M/m_CLKGEN_MMCM/clk_out1' to pin 'm_CLK25M/m_CLKGEN_MMCM/bbstub_clk_out1/O'

[Synth 8-565] redefining clock 'CLK'

[Synth 8-5819] Moved 1 constraints on hierarchical pins to their respective driving/loading pins

[Synth 8-5844] Detected registers with asynchronous reset at DSP/BRAM block boundary. Consider using synchronous reset for optimal packing ["C:/work/EyeTracker/designs/src/rtl/CALC_GRAVITY_Y.v":342]

[Project 1-571] Translating synthesized netlist

[Netlist 29-17] Analyzing 3211 Unisim elements for replacement

[Netlist 29-28] Unisim Transformation completed in 0 CPU seconds

[Project 1-570] Preparing netlist for logic optimization

[Opt 31-140] Inserted 1 IBUFs to IO ports without IO buffers.

[Opt 31-138] Pushed 0 inverter(s) to 0 load pin(s).

[Project 1-111] Unisim Transformation Summary:
No Unisim elements were transformed.

[Common 17-83] Releasing license: Synthesis

[Common 17-1381] The checkpoint 'C:/work/EyeTracker/designs/FPGA/project_1/project_1.runs/synth_1/TOP.dcp' has been generated.

[Common 17-206] Exiting Vivado at Fri Dec 22 08:16:12 2017...

Out-of-Context Module Runs
MEM_synth_1
[Synth 8-638] synthesizing module 'MEM' ["c:/work/EyeTracker/designs/FPGA/project_1/project_1.srcs/sources_1/ip/MEM/synth/MEM.vhd":76]

[Synth 8-256] done synthesizing module 'MEM' (9#1) ["c:/work/EyeTracker/designs/FPGA/project_1/project_1.srcs/sources_1/ip/MEM/synth/MEM.vhd":76]

[Device 21-403] Loading part xc7k160tfbg484-1

ILA_synth_1
[IP_Flow 19-4838] Using cached IP synthesis design for IP ILA, cache-ID = 491073c5c0128334.

CLKGEN_MMCM_synth_1
[Synth 8-638] synthesizing module 'CLKGEN_MMCM' ["c:/work/EyeTracker/designs/FPGA/project_1/project_1.srcs/sources_1/ip/CLKGEN_MMCM/CLKGEN_MMCM.v":70]

[Synth 8-256] done synthesizing module 'IBUF' (1#1) ["C:/Xilinx/Vivado/2016.4/scripts/rt/data/unisim_comp.v":14146]

[Device 21-403] Loading part xc7k160tfbg484-1

Implementation
Design Initialization
 Design is defaulting to srcset: sources_1

[filemgmt 56-147] Overwrite of existing file isn't enabled.  Please specify -force to overwrite file  [C:/work/EyeTracker/designs/FPGA/project_1/project_1.runs/impl_1/.Xil/Vivado-10768-ifdlwin0/DIV_28_20_2/DIV_28_20.dcp]

[Project 1-454] Reading design checkpoint 'C:/work/EyeTracker/designs/FPGA/project_1/project_1.runs/impl_1/.Xil/Vivado-10768-ifdlwin0/ILA/ILA.dcp' for cell 'm_ILA'

[Netlist 29-17] Analyzing 3993 Unisim elements for replacement

[Netlist 29-28] Unisim Transformation completed in 0 CPU seconds

[Project 1-479] Netlist was created with Vivado 2016.4

[Device 21-403] Loading part xc7k160tfbg484-1

[Project 1-570] Preparing netlist for logic optimization

[Opt 31-35] Removing redundant IBUF, m_CLK25M/m_CLKGEN_MMCM/inst/clkin1_ibufg, from the path connected to top-level port: CLK
Resolution: The tool has removed redundant IBUF. To resolve this warning, check for redundant IBUF in the input design.

[Constraints 18-550] Could not create 'IBUF_LOW_PWR' constraint because net 'm_CLK25M/m_CLKGEN_MMCM/clk_in1' is not directly connected to top level port. 'IBUF_LOW_PWR' is ignored by Vivado but preserved for implementation tool. ["C:/work/EyeTracker/designs/FPGA/project_1/project_1.runs/impl_1/.Xil/Vivado-10768-ifdlwin0/dcp_5/CLKGEN_MMCM.edf":508]

[Timing 38-35] Done setting XDC timing constraints. ["c:/work/EyeTracker/designs/FPGA/project_1/project_1.srcs/sources_1/ip/CLKGEN_MMCM/CLKGEN_MMCM.xdc":57]

[Timing 38-2] Deriving generated clocks ["c:/work/EyeTracker/designs/FPGA/project_1/project_1.srcs/sources_1/ip/CLKGEN_MMCM/CLKGEN_MMCM.xdc":57]

[Vivado 12-508] No pins matched 'm_CLK_UART_div_clk_reg/Q'. ["C:/work/EyeTracker/designs/syn/constraints/TOP_syn.xdc":40]

[Vivado 12-627] No clocks matched 'UART_X8_CLK'. ["C:/work/EyeTracker/designs/syn/constraints/TOP_syn.xdc":43]

[Vivado 12-626] No clocks found. Please use 'create_clock' or 'create_generated_clock' command to create clocks. ["C:/work/EyeTracker/designs/syn/constraints/TOP_syn.xdc":43]

[Vivado 12-4739] create_generated_clock:No valid object(s) found for '-objects [get_pins m_CLK_UART_div_clk_reg/Q]'. ["C:/work/EyeTracker/designs/syn/constraints/TOP_syn.xdc":40]

[Project 1-538] Using original IP XDC constraints instead of the XDC constraints in dcp 'C:/work/EyeTracker/designs/FPGA/project_1/project_1.runs/impl_1/.Xil/Vivado-10768-ifdlwin0/DIV_28_20_2/DIV_28_20.dcp'

[Opt 31-138] Pushed 0 inverter(s) to 0 load pin(s).

[Project 1-111] Unisim Transformation Summary:
  A total of 132 instances were transformed.
  CFGLUT5 => CFGLUT5 (SRLC32E, SRL16E): 132 instances

[Vivado_Tcl 4-424] Cannot write hardware definition file as there are no IPI block design hardware handoff files present

Opt Design
 Command: opt_design

[Common 17-349] Got license for feature 'Implementation' and/or device 'xc7k160t'

[Project 1-461] DRC finished with 0 Errors

[Project 1-462] Please refer to the DRC report (report_drc) for more information.

[IP_Flow 19-234] Refreshing IP repositories

[IP_Flow 19-1704] No user IP repositories specified

[IP_Flow 19-2313] Loaded Vivado IP repository 'C:/Xilinx/Vivado/2016.4/data/ip'.

[IP_Flow 19-3806] Processing IP xilinx.com:ip:xsdbm:2.0 for cell dbg_hub_CV.

[Chipscope 16-220] Re-using generated and synthesized IP, "xilinx.com:ip:xsdbm:2.0", from Vivado IP cache entry "1292fa24d95893cf".

[Opt 31-49] Retargeted 0 cell(s).

[Opt 31-138] Pushed 2 inverter(s) to 22 load pin(s).

[Opt 31-10] Eliminated 99 cells.

[Opt 31-194] Inserted BUFG CLK_IBUF_BUFG_inst to drive 196 load(s) on clock net CLK_IBUF_BUFG

[Opt 31-193] Inserted 1 BUFG(s) on clock nets

[Opt 31-12] Eliminated 11534 unconnected nets.

[Opt 31-11] Eliminated 1345 unconnected cells.

[Pwropt 34-132] Skipping clock gating for clocks with a period < 2.00 ns.

[Timing 38-35] Done setting XDC timing constraints.

[Pwropt 34-9] Applying IDT optimizations ...

[Pwropt 34-10] Applying ODC optimizations ...

[Pwropt 34-162] WRITE_MODE attribute of 0 BRAM(s) out of a total of 316 has been updated to save power. Run report_power_opt to get a complete listing of the BRAMs updated.

[Pwropt 34-201] Structural ODC has moved 0 WE to EN ports

[Common 17-83] Releasing license: Implementation

[Common 17-1381] The checkpoint 'C:/work/EyeTracker/designs/FPGA/project_1/project_1.runs/impl_1/TOP_opt.dcp' has been generated.

[DRC 23-27] Running DRC with 2 threads

[Coretcl 2-168] The results of DRC are in file "C:/work/EyeTracker/designs/FPGA/project_1/project_1.runs/impl_1/TOP_drc_opted.rpt".

Place Design
[Chipscope 16-240] Debug cores have already been implemented

 Command: place_design

[Common 17-349] Got license for feature 'Implementation' and/or device 'xc7k160t'

[DRC 23-27] Running DRC with 2 threads

[DRC 23-20] Rule violation (CHECK-3) Report rule limit reached - REQP-1839 rule limit reached: 20 violations have been found.

[Vivado_Tcl 4-198] DRC finished with 0 Errors

[Vivado_Tcl 4-199] Please refer to the DRC report (report_drc) for more information.

[Place 30-611] Multithreading enabled for place_design using a maximum of 2 CPUs

[Opt 31-138] Pushed 0 inverter(s) to 0 load pin(s).

[Timing 38-35] Done setting XDC timing constraints.

[Place 30-746] Post Placement Timing Summary WNS=-5.863. For the most accurate timing information please run report_timing.

[Common 17-83] Releasing license: Implementation

[Common 17-1381] The checkpoint 'C:/work/EyeTracker/designs/FPGA/project_1/project_1.runs/impl_1/TOP_placed.dcp' has been generated.

Route Design
 Command: route_design

[Common 17-349] Got license for feature 'Implementation' and/or device 'xc7k160t'

[Vivado_Tcl 4-198] DRC finished with 0 Errors

[Vivado_Tcl 4-199] Please refer to the DRC report (report_drc) for more information.

[Route 35-254] Multithreading enabled for route_design using a maximum of 2 CPUs

[Route 35-416] Intermediate Timing Summary | WNS=-5.833 | TNS=-283.383| WHS=-0.498 | THS=-4394.785|

[Route 35-57] Estimated Timing Summary | WNS=-6.665 | TNS=-2775.653| WHS=0.022  | THS=0.000  |

[Route 35-328] Router estimated timing not met.
Resolution: For a complete and accurate timing signoff, report_timing_summary must be run after route_design. Alternatively, route_design can be run with the -timing_summary option to enable a complete timing signoff at the end of route_design.

[Route 35-16] Router Completed Successfully

[Common 17-83] Releasing license: Implementation

[Common 17-1381] The checkpoint 'C:/work/EyeTracker/designs/FPGA/project_1/project_1.runs/impl_1/TOP_routed.dcp' has been generated.

[DRC 23-27] Running DRC with 2 threads

[Coretcl 2-168] The results of DRC are in file "C:/work/EyeTracker/designs/FPGA/project_1/project_1.runs/impl_1/TOP_drc_routed.rpt".

[DRC 23-133] Running Methodology with 2 threads

[Coretcl 2-1520] The results of Report Methodology are in file "C:/work/EyeTracker/designs/FPGA/project_1/project_1.runs/impl_1/TOP_methodology_drc_routed.rpt".

[Timing 38-35] Done setting XDC timing constraints.

[Timing 38-91] UpdateTimingParams: Speed grade: -1, Delay Type: min_max.

[Timing 38-191] Multithreading enabled for timing update using a maximum of 2 CPUs

[Timing 38-282] The design failed to meet the timing requirements. Please see the timing summary report for details on the timing violations.

Write Bitstream
 Command: write_bitstream -force -no_partial_bitfile TOP.bit

[Common 17-349] Got license for feature 'Implementation' and/or device 'xc7k160t'

[DRC 23-27] Running DRC with 2 threads

[DRC 23-20] Rule violation (CFGBVS-3) CONFIG_VOLTAGE Design Property - The CONFIG_VOLTAGE property is not set for current_design. To indicate what the configuration bank VCCO will be, the CONFIG_VOLTAGE property must be set to 1.5, 1.8, 2.5, or 3.3.  Refer to device configuration user guide for more information.

[Vivado 12-3199] DRC finished with 0 Errors, 70 Warnings

[Vivado 12-3200] Please refer to the DRC report (report_drc) for more information.

[Vivado 12-1842] Bitgen Completed Successfully.

[Project 1-118] WebTalk data collection is enabled (User setting is ON. Install Setting is ON.).

[Common 17-186] 'C:/work/EyeTracker/designs/FPGA/project_1/project_1.runs/impl_1/usage_statistics_webtalk.xml' has been successfully sent to Xilinx on Fri Dec 22 08:35:46 2017. For additional details about this file, please refer to the WebTalk help file at C:/Xilinx/Vivado/2016.4/doc/webtalk_introduction.html.

[Common 17-83] Releasing license: Implementation

```[Vivado_Tcl 4-395] Unable to parse hwdef file TOP.hwdef

watari3, 2017-12-24:
TOP_syn.xdcをfeature/issue_28ブランチにpushしました。
下記でテスト願います。

1) INP_CAMERA_DATAのCLKクロック極性をposiにしてインプリメンテーション
2) 1)がNGの場合、INP_CAMERA_DATAのCLKクロック極性をnegaにしてインプリメンテーション

akita11, 2017-12-24:
いまから試してみます。確認ですが、1.の「CLKクロック極性をposi」とは、INP_CAMERA_DATAのインスタンス化のところを、元のように
`    INP_CAMERA_DATA  #( .PIXEL_WIDTH(PIXEL_WIDTH) )    m_INP_CAMERA_DATA (.CLK(CCLK), .RST_N(RST_N),
`
とする、という意味ですよね。

akita11, 2017-12-25:
まず前者の1.を試してみました（↑の内容）。現象に変わりはありませんでした。
いまから2.を試してみます。

watari3, 2017-12-25:
ご認識どおりです。

(そうなる可能性は低いですが)データーシートの仕様通りなら1st F/FのクロックエッジがposiならSTAの結果からNG画面(*1)になる確率が上がるはずです。

また1st F/Fのクロックエッジがnegaなら安定した結果になるはずです。

この2点実施して結果が変わらないのであれば、以下の3つを試してみる必要があると思います。
1,2を試していただけないでしょうか。
3について分かられるようでしたら作業していただけないでしょうか。
わからない場合はストラテージの変更については説明資料を、ツールのバージョン変更については2017.4向けのアーカイブデータを作成します。

1 FPGAのコア電圧(1.2V?1.0V?1.8V?)が規定どおりか確認する
2 入力のタイミングが仕様どおりか確認する
⇒オシロスコープで測定必要
3 ツールのバージョンもしくは合成ストラテージを変更してbinファイルを作り直す

*1)
データスキューなどの影響で画面が乱れやすくなる

akita11, 2017-12-26:
おそくなりました、2.を試しましたが、現象は変わりませんでした。

また↑の3点、
1.は、FPGAがのっているボードは、ヒューマンデータのモジュール（ボード）で、そこには3.3V（先日観測したとおり充分安定）を与えていて、そこから先は、ヒューマンデータのボードを信じて、FPGAコア電圧は安定、と考えるのが妥当かと考えます。（ボードの回路図はあるがアートワークとの対応がわかわず、電圧を測定する箇所を探すのが難儀そう）
2.はCameraLinkレシーバからの出力（シリ→パラ変換後）の、クロックと各データのタイミング、ですよね。これはあとで確認しておきます。（が、これもデータシートに載っている情報なので信じるのが妥当＝ここが問題である可能性はきわめて低いかと思いますが・・・）
3.は、合成ストラテジーといいますと、速度優先や面積優先、とかですかね。ちょっとVivadoではやったことがないので、簡単でけっこうです、どこを見ればよいか情報いただけますか。またVivado2017.4は、いまのプロジェクトファイル一式のまま、では使えないんでしたっけ。

watari3, 2017-12-26:
1.に関してですがヒューマンデータのモジュールボード上のDCDC ICの不具合？を疑っています。
可能性は低いですがないことはないので。
測定が難しい場合は回路にXADCを実装することで、JTAGなどでジャンクション温度に加え各種電源電圧も観測できます。

2.に関してですが特定IO Bufferの不具合、ダンピング抵抗の接触問題なども可能性が高くはありませんが疑っています。
またデーターシートに記載がありますがあくまでも85MHzにおける話ですので念のための確認は行っても良いかと思います。
3.下記URLの資料8ページ目以降を参照願います。
https://www.xilinx.com/support/documentation/sw_manuals_j/xilinx2016_4/ug901-vivado-synthesis.pdf
2017.4ですが、一応そのままプロジェクトファイルを読み込むことで作業できます。但しIPのバージョンアップについては手動で行う必要あり。

akita11, 2017-12-27:
本件、年明けに、測定などしてみます、少しお時間ください

watari3, 2017-12-30:
XADCをインプリメントしてジャンクション温度及び各種電源電圧をUART経由で読み出せるようにいたしましょうか。

akita11, 2017-12-30:
お願いできると幸いです。それか遣り方をおしえていただくのでもいいです。

2017/12/30 16:39 "watari3" <notifications@github.com>:

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

watari3, 2018-01-01:
XADCの資料は下記になります。
ご参考願います。

https://japan.xilinx.com/support/documentation/user_guides/j_ug480_7Series_XADC.pdf

またUART HOST IFのメモリマップを拡張しXADCを0x100以降にマッピングする予定です。

akita11, 2018-01-04:
まずは電源電圧（の一部）をDSO(Tek TDS2024B)ではかって見ました。測定箇所は、こちらの回路図のEM1, EM3, EM5のFPGA側（標準電圧はそれぞれ1.0V, 1.8V, 1.2V）です。なお回路は、↑の2.の回路（INP_CAMERA_DATAのCLKクロック極性をnegaにしたもの）を書き込んで動作させている状態です。
https://www.dropbox.com/s/w61lotb6sq2zmto/XCM112R1-SCH-B.pdf?dl=0
それぞれの波形は以下のようでした。標準より0.1V程度高いところはありますが、少なくともリプルはなさそうです。
https://www.dropbox.com/s/bvk02o20op96cg2/V_EM1_VCCINT_10.BMP?dl=0
https://www.dropbox.com/s/yttcytma3mlwwac/V_EM3_VCCAUX_18.BMP?dl=0
https://www.dropbox.com/s/g62fzpe8t6715pk/V_EM5_VMGTAVTT_12.BMP?dl=0

またDS90CR288A（CameraLink→パラレル変換）の出力側を、FPGAボードコネクタ側端に等長のビニール線(3cm程度)をハンダ付けしてDSO(Tek MSO2012B)で、RxOUT0とRxOUT27について、RxCLKとともに測ってみました（2chのDSOのため、2波形しか同時に測れないため、2つにわけて測定しています）なおRxOUT0/27は0/1の変換が不規則なため、64回のaverageをかけています（タイミングをみるだけであればこれでよいと判断しました）
黄=RxCLK、青=RxOUT0
https://www.dropbox.com/s/bfv6p28n3s2slp8/DS90CR288A_RxCLK_RxOUT0.png?dl=0

黄=RxCLK、青=RxOUT27
https://www.dropbox.com/s/st6ziyl45r2pryp/DS90CR288A_RxCLK_RxOUT27.png?dl=0

参考：DS90CR288Aのデータシート
https://www.dropbox.com/s/dklopeaoasshi8y/DS90CR288.pdf?dl=0

DS90CR28AAのデータシートによれば、Setup/Holdはいずれも3.5ns(min)ですので、満たしているように見えます。

akita11, 2018-01-04:
XADCでINT/AUXの電圧をJTAG経由ではかってみました。特に問題はなさそうです。
https://gyazo.com/c6ff51fefdc9d163d60165fe813d56d3

watari3, 2018-01-04:
下記の点が気になります。ご回答いただけないでしょうか。

1) XADCの結果は問題発生時でしょうか？
2) FPGAの入力信号の電圧レベルが低いように見えますがVIHを超えているのでしょうか？
3) 問題発生後FPGAに対してリセットをかけるとどうなりますか？

akita11, 2018-01-04:
1.→はいそうです（というか最近はずっと問題発生（縦縞がでる）が継続しています）
2.→RxCLK等のDSO波形のことでしょうか。青のほうはaverageをとっているので電圧が低いように見えますが、averageをとらないと、（波形がすばやく変化して測定をしにくいですが）Hの電圧は3V程度はあるようです
3.→同じ現象です（縦縞が出た状態）

akita11, 2018-01-04:
ボード（HDLボードではなく、シリパラなどが載っている自作ボード）の不良では？と考え、予備のボードに交換したところ、縦縞は消え、正常っぽい画像が表示されています。なお使っている回路は、当初の回路（クロックエッジを逆にしていない）ものです。シリパラICの個体差か、半田不良でしょうか・・・しばらく様子をみてみます。

watari3, 2018-01-28:
本件如何でしょうか？
問題が解決していましたらクローズしたくコメントお願いいたします。

akita11, 2018-01-28:
手が回っておらず未着手です、進捗は適宜報告します

2018/01/28 17:27 "watari3" <notifications@github.com>:

本件如何でしょうか？
問題が解決していましたらクローズしたくコメントお願いいたします。

—
You are receiving this because you authored the thread.
Reply to this email directly, view it on GitHub
<https://github.com/akita11/EyeTracker/issues/28#issuecomment-361046379>,
or mute the thread
<https://github.com/notifications/unsubscribe-auth/AFuOtlnud36COlLzTfkXHmTKd6lHlIPEks5tPC-HgaJpZM4RDOaa>
.

Thread 29 (2017-12-27):

support_SPARTAN6でカメラ画像を取得不良

akita11, 2017-12-27:
support_SPARTAN6をSPARTAN6ボードで動作させると、VGA出力で表示されるカメラ画像が、左側40画素程度分のみになっている。残りの右側600画素程度分は真っ黒のまま。
なお表示されている40画素程度分のエリアの縦はカメラに設定したROIのサイズになっていて、またカメラにうつす対象物を動かすと、それにあわせてVGA出力表示も動く。
また重心位置の赤字マークは、表示はされているが、その位置は、対象物を固定した状態でも、表示エリア内でフレームごとに不規則に移動しており、表示されているエリア内の黒領域の正しい重心位置であるとは思われない。

watari3, 2017-12-29:
> ROIのサイズ

これはどういう事を指しているのでしょうか？

akita11, 2017-12-29:
カメラの設定で、出力する範囲を640x170に設定していて、縦方向が170画素しかでてきません。
VGS出力させるモニタ画像では、縦方向が170画素分しか表示せれていません。
つまり縦方向のカメラからの読み込み(FVAL同期)は大丈夫そう、という意味です。

2017/12/29 9:30 "watari3" <notifications@github.com>:

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

watari3, 2017-12-30:
ToDo及び進捗状況

- ISEのisimでタイミングシミュレーション (CentOS7ではisimで致命的エラー発生。CentOS6でism実施予定(OS環境調達必要))
- CedenceのIUSでタイミングシミュレーション(ライブラリの読み込み手法調査要。sdf annotation用のコード必要。VCDまたはfsdb(どちらも波形データーベース)出力用コードの準備要。)
- 実機向けに入力信号測定回路を作成し、内部状況把握 (コーディング中)

akita11, 2018-01-04:
動作時のVGAモニタの様子を記録しておきます。
画面の左端10画素程度のみ、映像と思われるものがうつっています（カメラの対象物を動かすとそれに応じて動いているようには見える）
https://www.dropbox.com/s/439gomuvkej7hc1/180104Monitor1.jpg?dl=0

サイズがわかりにくいので、モニタ全体もあわせて撮影しました。拡大するとうっすらと左端のほうに、上記表示エリア（グレー）が見えます。
https://www.dropbox.com/s/q0muif8t5d79ecj/180104Monitor2.jpg?dl=0

akita11, 2018-01-05:
issue #28 で話の出た、Kintex7版のほうでボードを交換したら正常動作した、という件、こちらのSpartan6でも、このボードで動作させてみましたが、現象は変わらず（左端10画素分程度のみ表示）でした。

akita11, 2018-01-06:
CLctrl.vのfor文のところ、動作内容というか設計意図を確認させてください。140行目からのfor文のところは以下のようになっています。
```
            for (i=0; i<MDATA_WIDTH;i=i+2) begin
                if (col == i) begin
                    oMEMIN_0[i  ] <= (iDATA_L<iTHRESHOLD) ? iDE: 1'b0; // flag=1 for dark pixel and when iDE = high
                    oMEMIN_0[i+1] <= (iDATA_R<iTHRESHOLD) ? iDE: 1'b0; // flag=1 for dark pixel and when iDE = high
                end else begin
                    oMEMIN_0[i  ] <= oMEMIN_0[i  ];
                    oMEMIN_0[i+1] <= oMEMIN_0[i+1];
                end
            end
```
これは、アクセス中の列(col)のみoMEMIN_0を、画素値に応じてフラグをセットし、それ以外の列は変化させない、ということですよね。
そのような動作であれば、以下のような記述でもできそうな気がしますが、これだとマズいですか？
```
                    oMEMIN_0[col  ] <= (iDATA_L<iTHRESHOLD) ? iDE: 1'b0; // flag=1 for dark pixel and when iDE = high
                    oMEMIN_0[col+1] <= (iDATA_R<iTHRESHOLD) ? iDE: 1'b0; // flag=1 for dark pixel and when iDE = high
```

akita11, 2018-01-06:
↑のようにCLctrl.vを修正し、動作させてみましたが、現象は変わりませんでした。
ところでいま気づいたのですが、VGAモニタの右端のほうに、薄い矩形エリアが表示されているようです。具体的には、モニタの右端から横20画素程度、縦480画素（画面の高さいっぱい）の、薄い（たぶん輝度20/255くらい）矩形と、その左側に、同じくらいのサイズで、もう少し輝度が薄いエリアがあります。VGA表示メモリの残り、ですかね。

akita11, 2018-01-06:
Cadence/Synopsysを使うサーバの準備がほぼできました（git2だけまだですがそれも近日中）。

watari3, 2018-01-07:
修正前のコードは変化なしデータも明示的に保持させるために記載しています。
修正後のコードは変化なしデータに対する処理を省略しています。

明示的に記載したほうが安全なのでそうしています。

輝度20/255位とのことですが、やはり配線がおかしくなっている可能性が高そうですね。

GateSimに関しては後ほど関連資料やファイルをpushしておきます。

watari3, 2018-01-08:
gatesimが出来そうな環境をpushしました。

./designs/ISE/EyeTracker_SPARTAN6/set_timesim.sh (UTF-8)にGatesimの事前準備方法を記載しておきました。こちらを参照し準備ください。

準備後Linuxにて./designs/sim/ディレクトリに移動後./prepare_env_setting.shを実行し
ncverilog -f run_gate.fを実行ください。

なおprepare_env_setting.sh及びrun_gate.fに自分の環境に合うようVerdi及びIUSの環境を設定ください。

問題がありましたら./log/及び./sdf/下のファイルをご提供ください。

または軽確認はnWaveにて波形ビューアが起動し、./fsdb/TOP.fsdbを読み込むことで波形確認できます。

akita11, 2018-01-18:
一応確認ですが、↑は、feature/issue29ブランチ、ですよね？

watari3, 2018-01-18:
はい。それです。
