akita11/EyeTracker/doc/schematic.pdf

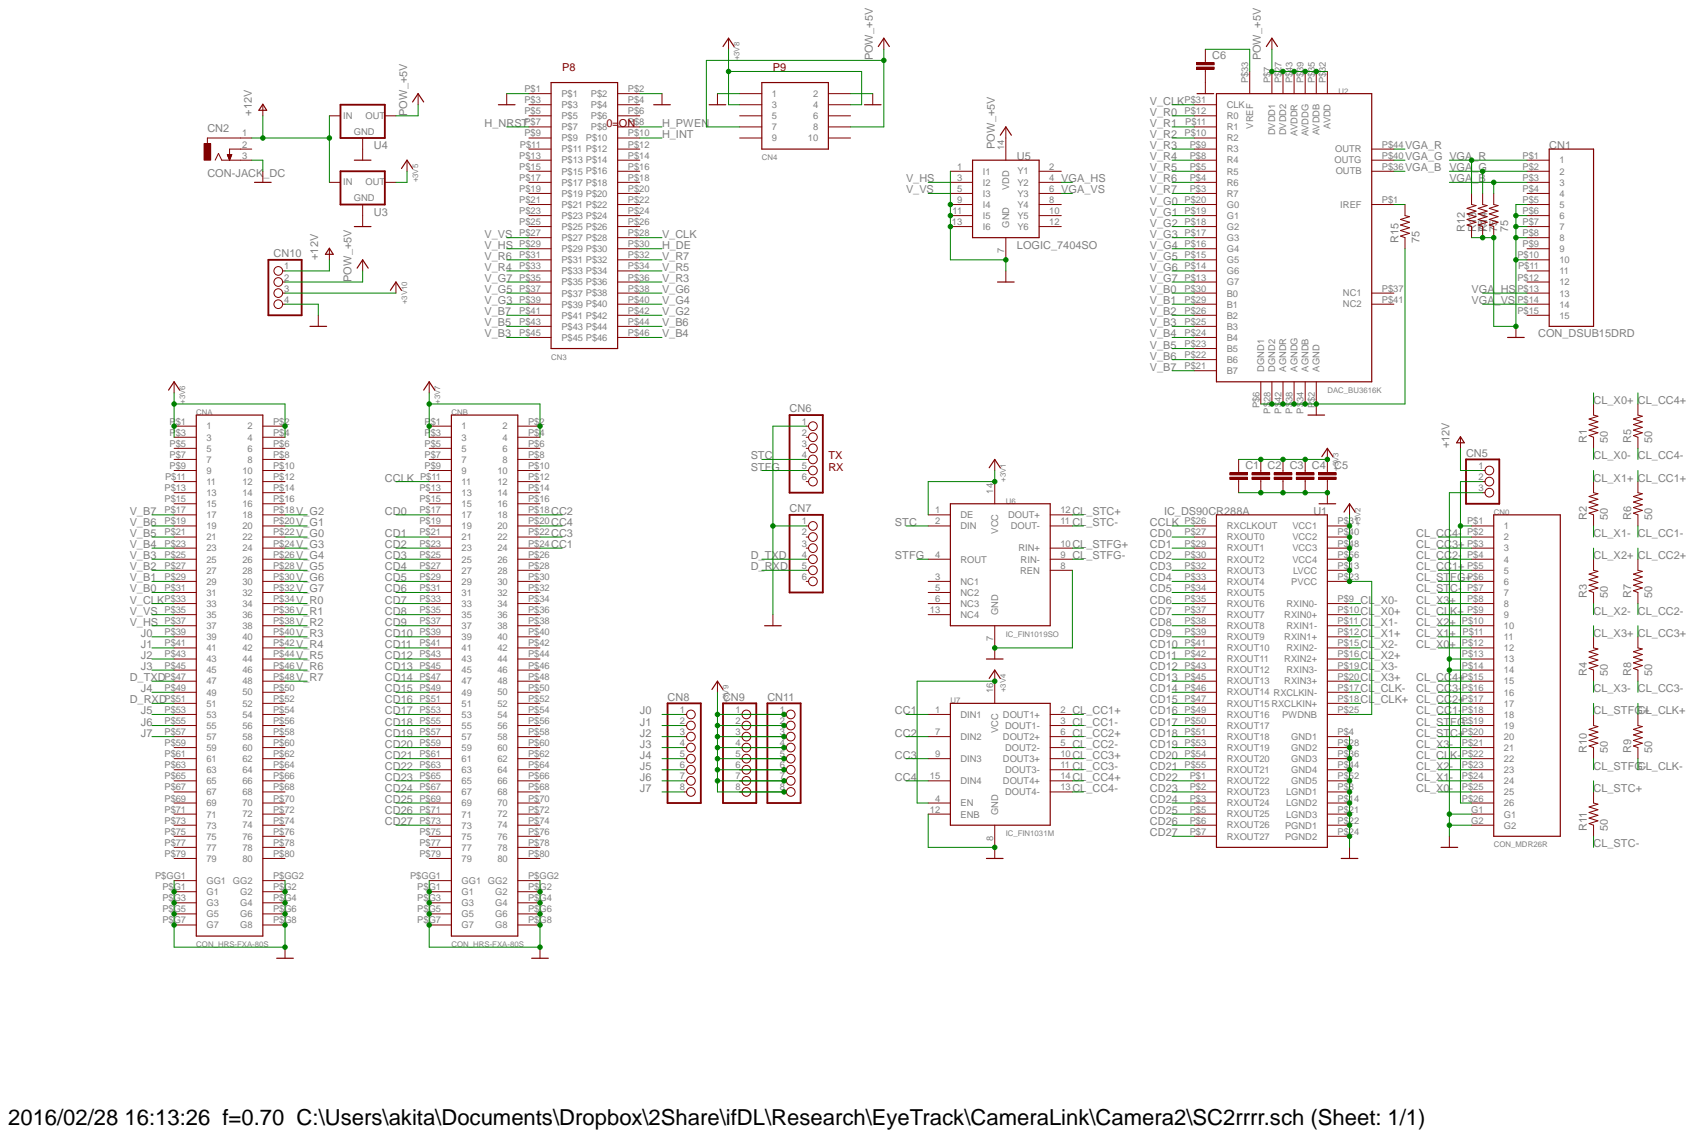
[picture p1: page 1]

2016/02/28 16:13:26 f=0.70 C:\Users\akita\Documents\Dropbox\2Share\ifDL\Research\EyeTrack\CameraLink\Camera2\SC2rrrr.sch (Sheet: 1/1)
