akita11/EyeTracker/(commit log)

2017-03-11 Fitst release.
    [SC2_pin.xls]
2017-04-16 Support CALC_GRAVITY. Output sum_s, sum_sx and sum_sy value via UART.
2017-05-04 Change signal format from CAMERA link to RGB video signal. Fix bug (Do not work UART IF when calculate complete.) Add time out logic.
    [CALC_GRAVITY_Y.v]
2017-05-04 Change signal format from CAMERA link to RGB video signal.
2017-05-04 Fix bug (Output wrong data during uart access on TXD.)
    [CALC_GRAVITY_Y.v]
2017-05-04 Change signal format from CAMERA link to RGB video signal. Change output video timing from original timing to VESA timing. Fix UART bug.
    [TOP.v]
2017-05-19 VGAoutのHSYNC/VSYNCの極性を変更
2017-05-19 VGAoutのHSYNC/VSYNCの極性の変更
2017-05-21 .gitignoreの追加
2017-05-21 UARTピンのTXとRXのピン番号指定を入れ替え。.gitignoreにproject1.hw/を追加。
2017-05-25 Fix typo. (Output all zero data and loop issue.)
    [UART_IF.v]
2017-05-25 Fix polarity issue. (Close #13)
    [TOP.v]
2017-05-30 VGAOUTmodeをinputにしてボードのSW1[2]に割り当て。CLctrlで二値化条件の不等号を反転（黒画素にフラグをたてる）。UART_IF.vにissudeで指定された修正（行末コードを0x0aに）。JPピンのプルダウン指定（とVGAOUTmodeの指定）をTOPimplement.tclに追加。
2017-05-31 Remove unused files from repository. Add oFIELD signal in INP_CAMERA_DATA module. Change select signal of frame buffer from field signal by VGA clock domain to field signal by Camera clock domain.
2017-05-31 Change select signal for frame buffer from field signal by VGA clock domain to field signal by Camera clock domain.
2017-06-01 Change maximum size from fixed value (horizontal and vertical) to limitation value from input camera link.
    [CALC_GRAVITY_Y.v]
2017-06-06 Fix typo. (Connection issue about sx and sy.) Change select signal for SRAM to reduce collision of SRAM access.
    [TOP.v]
2017-06-13 Support UART Host I/F
2017-06-13 Update UART Rx and UART Tx core.
2017-06-14 Add decode error function.
    [CONV_HEX.v, CONV_HEX_UNIT.v]
2017-06-14 Improve parser logic. (Check strictly syntax.) Fix incorrect read issue.
    [HOST_IF_CORE.v]
2017-06-14 Fix incorrect read issue. (Expand signal width to capture correctly signal.)
    [TOP.v]
2017-06-15 Fix incorrect output video data issue.
    [TMG_CTRL.v, TOP.v]
2017-06-18 Update UART Tx & UART_Rx task.
2017-06-19 Fix bug. (Lack signal width issue.)
    [TOP.v]
2017-06-20 Fix QSX and QSY issue. Fix meta-stable issue.
    [CALC_GRAVITY_Y.v]
2017-06-21 Add error detection for ASCII character. (IsXDIGIT)
    [TOP.v, UART_IF.v]
2017-06-25 Add port to fix warning.
    [CALC_GRAVITY_Y.v]
2017-06-25 Add new clock constraints. But it does not work fine.
    [TOP_syn.xdc]
2017-12-04 Change polarity of RESET from active low to active high for Spartan6. (Kintex-7 is active low.)
    [CLK25M.v]
2017-12-20 Modified RTL file to resolve UART issue.
    [CLK_DIVIDER.v, TOP.v, TOP_syn.ucf, UART_IF.v, UART_RX_CORE.v, UART_TX_CORE.v]
